TiZed/ZFTuner/ZFTuner_3D.jpg

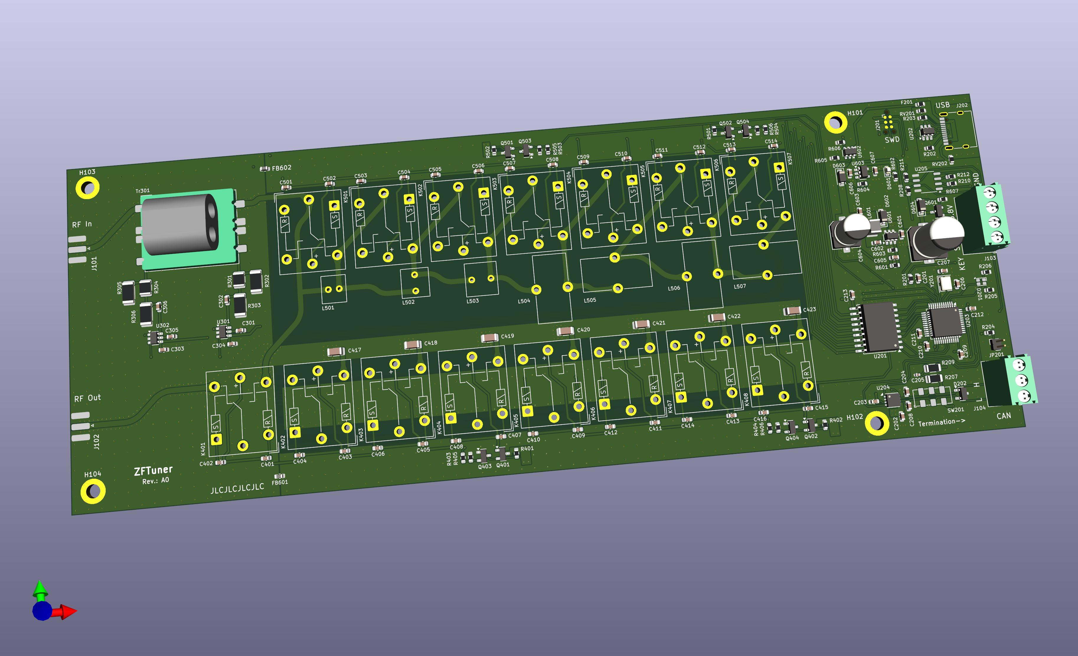
ZFTuner_3D.jpg
