TiZed/ZFTuner/ZFTuner_PCB_Editor.jpg

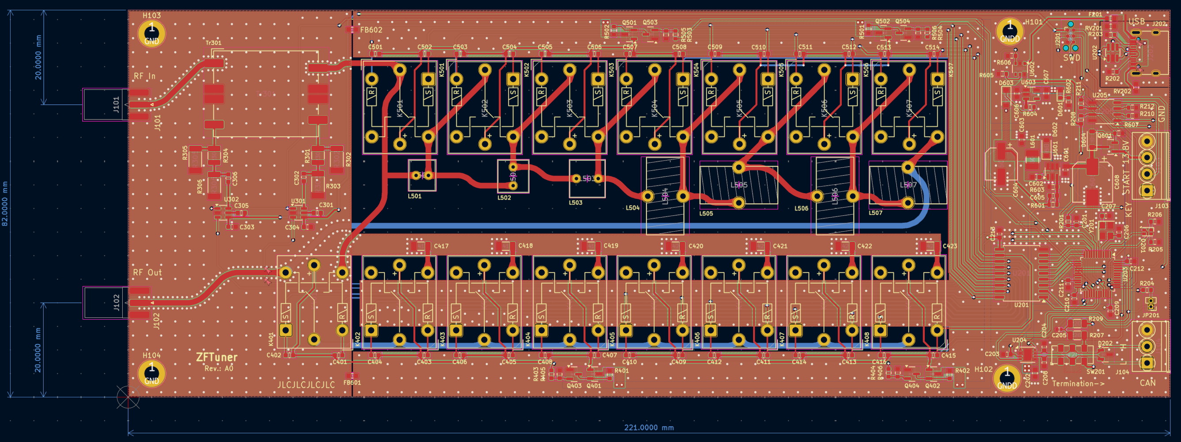
ZFTuner_PCB_Editor.jpg
