TiZed/ZFTuner/README.md

# ZFTuner

A 100W automatic antenna tuner, utilizing latching relays.

This project is still work in progress...

CC BY-NC-SA 4.0 Deed\
https://creativecommons.org/licenses/by-nc-sa/4.0/
