TiZed/ZFTuner/Coils/Coil_Form.FCStd

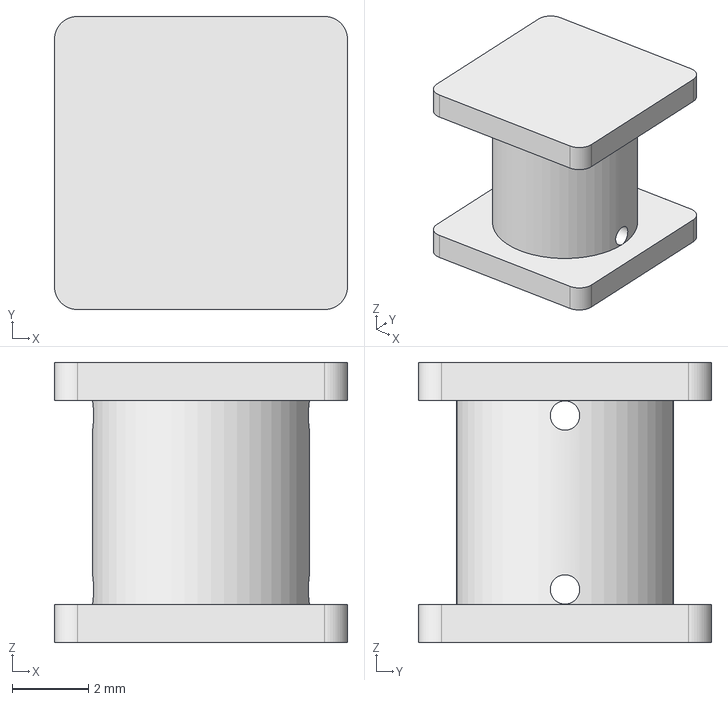
[picture p3: CAD file, 2024-04-15]
Coils/Coil_Form.FCStd
7.70 x 7.70 x 7.36 mm
