TiZed/ZFTuner/Directional_Coupler/Directional_Coupler.step

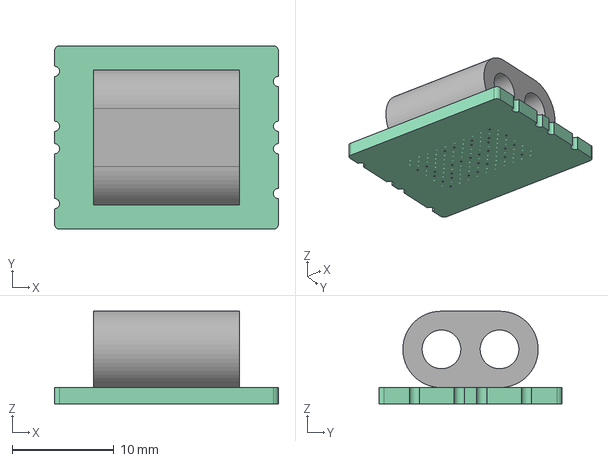
[picture p4: CAD file, 2024-03-23]
Directional_Coupler/Directional_Coupler.step
22.0 x 18.0 x 9.10 mm
Pcb_3e21
${REFERENCE}_Extrude_null
