TiZed/ZFTuner/Coils/Coil_Form-4.3D_3.35CL_5.35L_6.3H_50.5nH_N3.stl

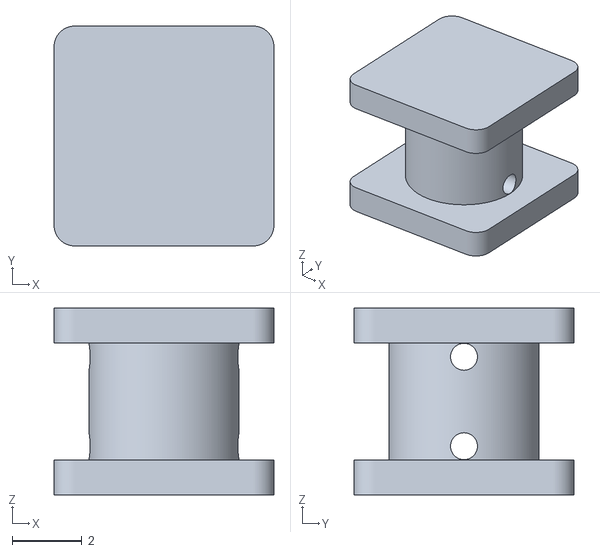
[picture p5: CAD file, 2024-04-14]
Coils/Coil_Form-4.3D_3.35CL_5.35L_6.3H_50.5nH_N3.stl
6.30 x 6.30 x 5.35
