TiZed/ZFTuner/Directional_Coupler/BN43-202.step

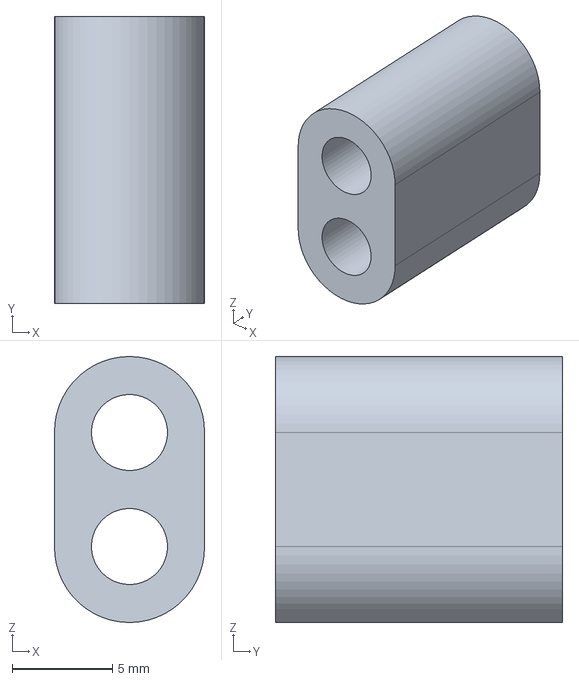
[picture p6: CAD file, 2024-03-23]
Directional_Coupler/BN43-202.step
7.50 x 14.4 x 13.3 mm
