TiZed/ZFTuner/Coils/Coil_Form-4.3D_4.69CL_6.69L_6.3H_100.3nH_N5.stl

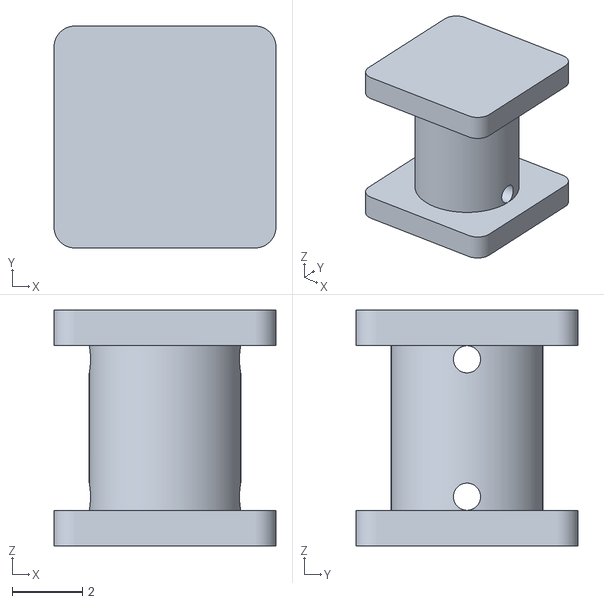
[picture p7: CAD file, 2024-04-14]
Coils/Coil_Form-4.3D_4.69CL_6.69L_6.3H_100.3nH_N5.stl
6.30 x 6.30 x 6.69
