TiZed/ZFTuner/(list of files, cad)

Other CAD files:
Coils/Coil_Form-5.7D_5.36CL_7.36L_7.7H_222nH_N6.stl
Directional_Coupler/Directional_Coupler.FCStd
