TiZed/ZFTuner/Firmware/LTC55507_Characteristics.ods

RF Power | Vout
[dBm] | [mV]
-34 | 270
-30 | 275
-26 | 280
-22 | 310
-18 | 350
-16 | 400
-14 | 460
-12.5 | 500
-10 | 580
-6 | 675
-5 | 700
-2 | 775
0 | 850
1 | 900
2 | 950
4 | 1080
6 | 1250
8 | 1450
10 | 1700
12 | 2000
14 | 2400
