TiZed/ZFTuner/ZFTuner.pdf

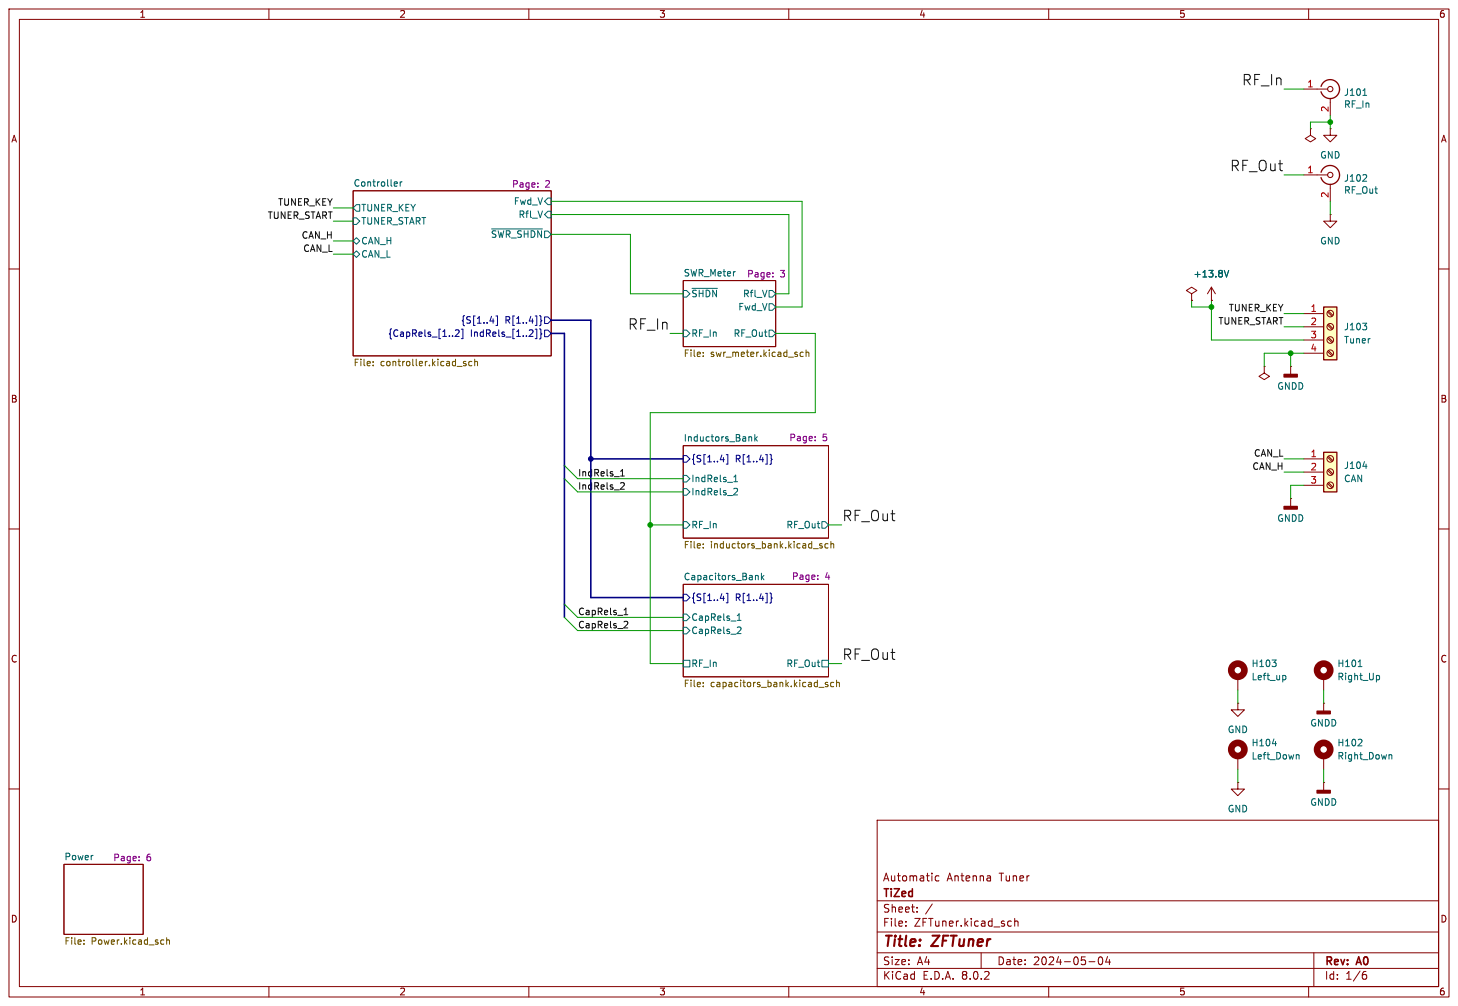
[picture p8: page 1]

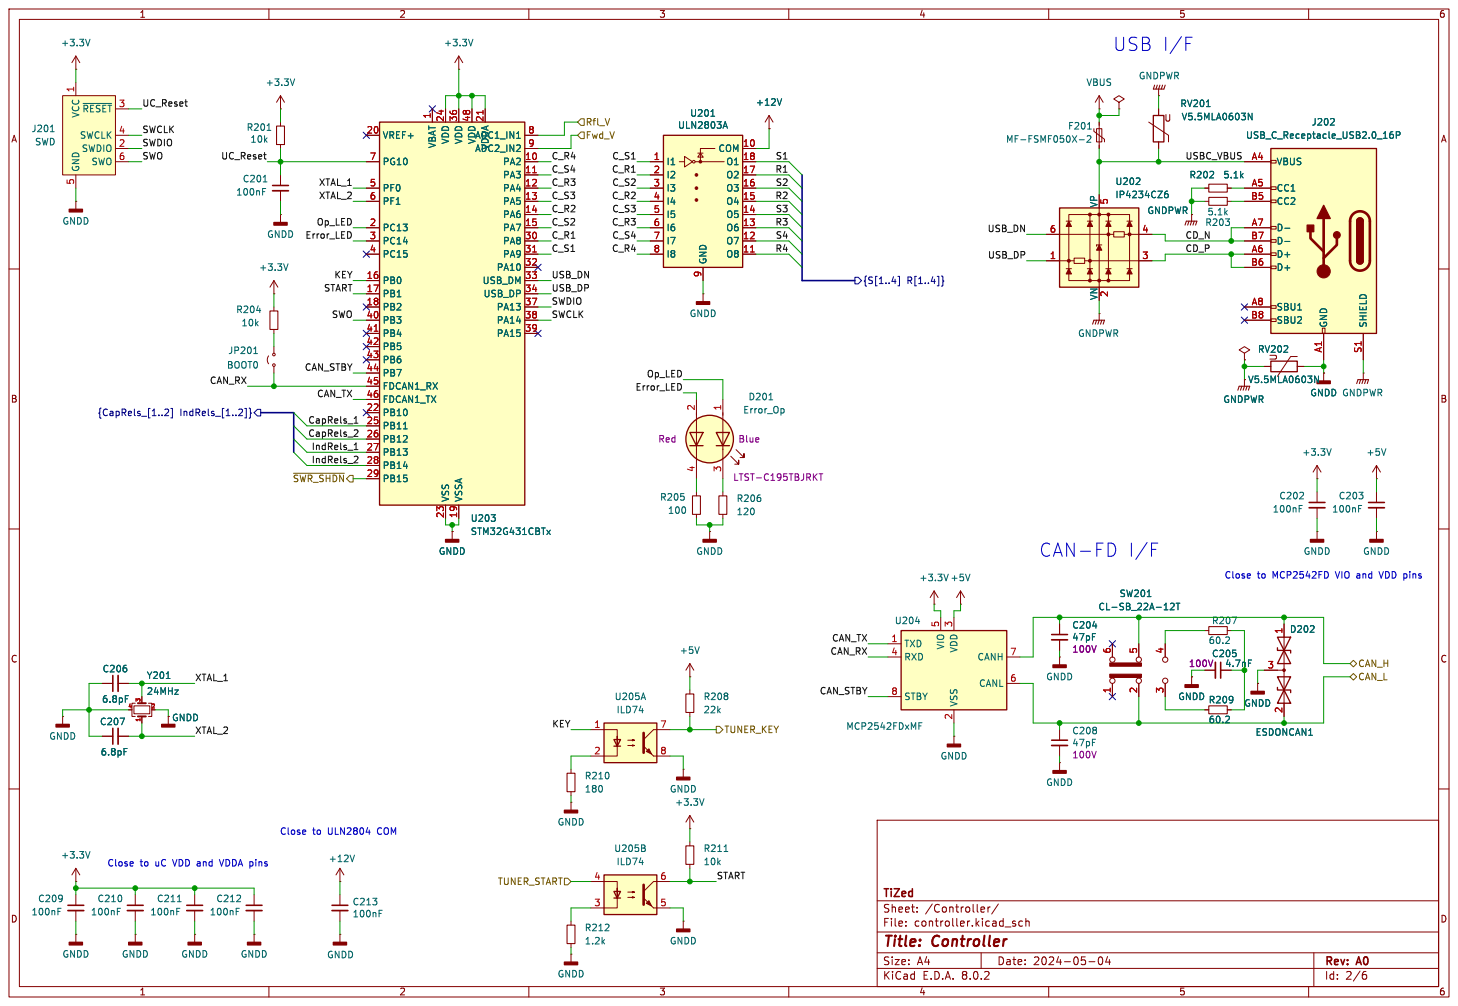
[picture p9: page 2]

1 PA2 10 PA3 11 PA4 12 PA5 13 PA6 14 PA7 15 PB0 16 PB1 17 PB2 18 VSSA 19 PC13 2 VREF+ 20 VDDA 21 PB10 22 VSS 23 VDD 24 PB11 25 PB12 26 PB13 27 PB14 28 PB15 29 PC14 3 PA8 30 PA9 31 PA10 32 USB_DM 33 USB_DP 34 VDD 36 PA13 37 PA14 38 PA15 39 PC15 4 PB3 40 PB4 41 PB5 42 PB6 43 PB7 44 FDCAN1_RX 45 FDCAN1_TX 46 VDD 48 PF0 5 PF1 6 PG10 7 ADC1_IN1 8 ADC2_IN2 9 U203 STM32G431CBTx GNDD

1 PA2 10 PA3 11 PA4 12 PA5 13 PA6 14 PA7 15 PB0 16 PB1 17 PB2 18 VSSA 19 PC13 2 VREF+ 20 VDDA 21 PB10 22 VSS 23 VDD 24 PB11 25 PB12 26 PB13 27 PB14 28 PB15 29 PC14 3 PA8 30 PA9 31 PA10 32 USB_DM 33 USB_DP 34 VDD 36 PA13 37 PA14 38 PA15 39 PC15 4 PB3 40 PB4 41 PB5 42 PB6 43 PB7 44 FDCAN1_RX 45 FDCAN1_TX 46 VDD 48 PF0 5 PF1 6 PG10 7 ADC1_IN1 8 ADC2_IN2 9 C207

Close to MCP2542FD VIO and VDD pins

Close to uC VDD and VDDA pins Close to ULN2804 COM

Id: 2/6 Title: Controller File: controller.kicad_sch Sheet: /Controller/ TiZed R212

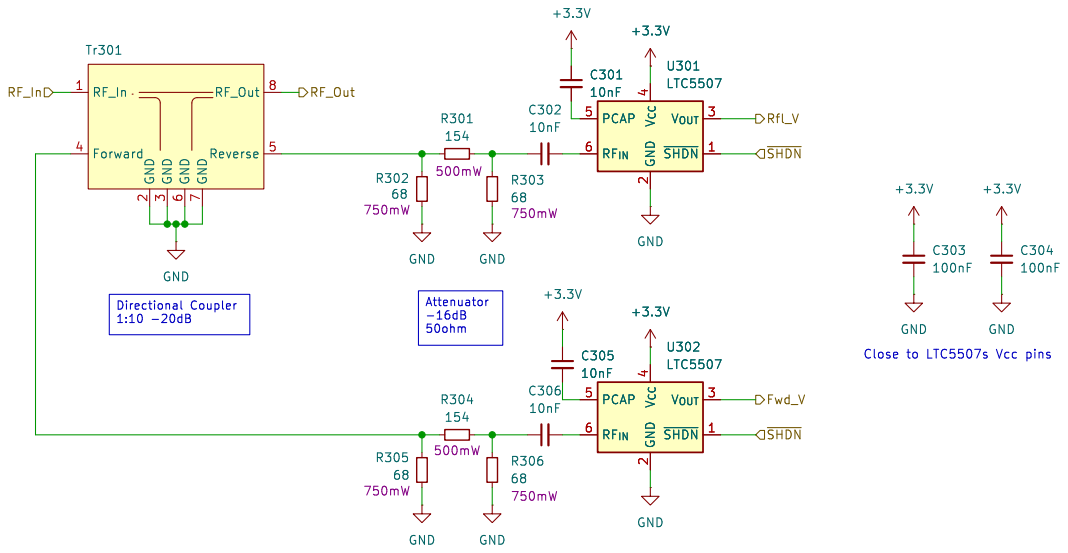
[picture p10: page 3]

2 V_{OUT} 3 V_{CC} 4 PCAP 5 RF_{IN} 6 +3.3V C301

2 V_{OUT} 3 V_{CC} 4 PCAP 5 RF_{IN} 6 U301

2 V_{OUT} 3 V_{CC} 4 PCAP 5 RF_{IN} 6 +3.3V U302

2 V_{OUT} 3 V_{CC} 4 PCAP 5 RF_{IN} 6 U302

Id: 3/6 Title: SWR Meter File: swr_meter.kicad_sch Sheet: /SWR_Meter/ TiZed

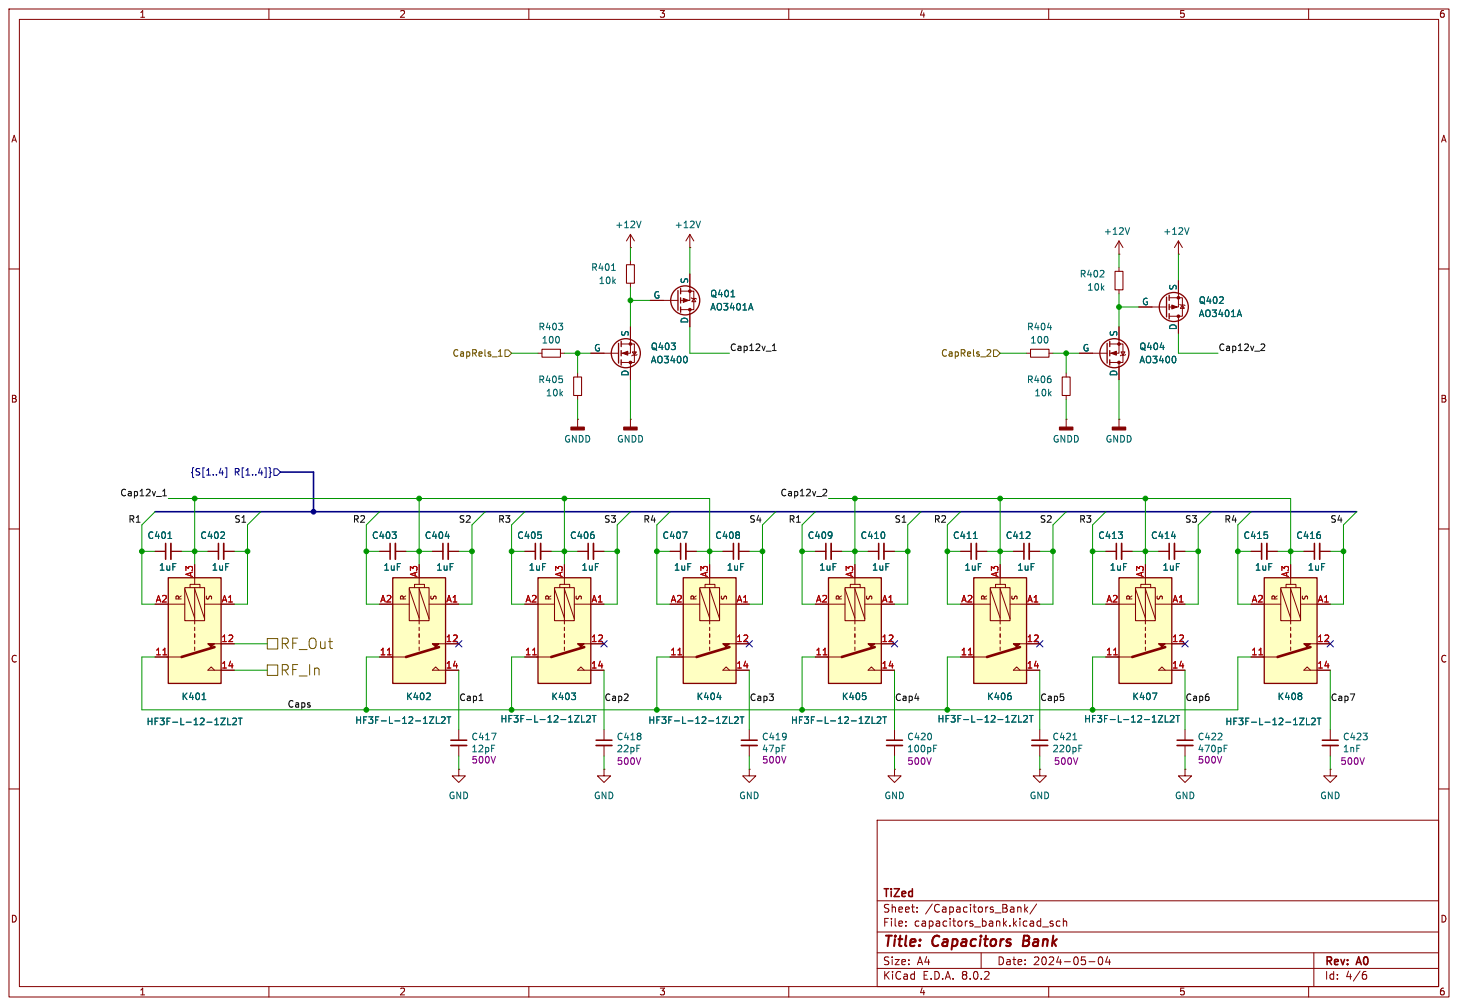
[picture p11: page 4]

Id: 4/6 Title: Capacitors Bank

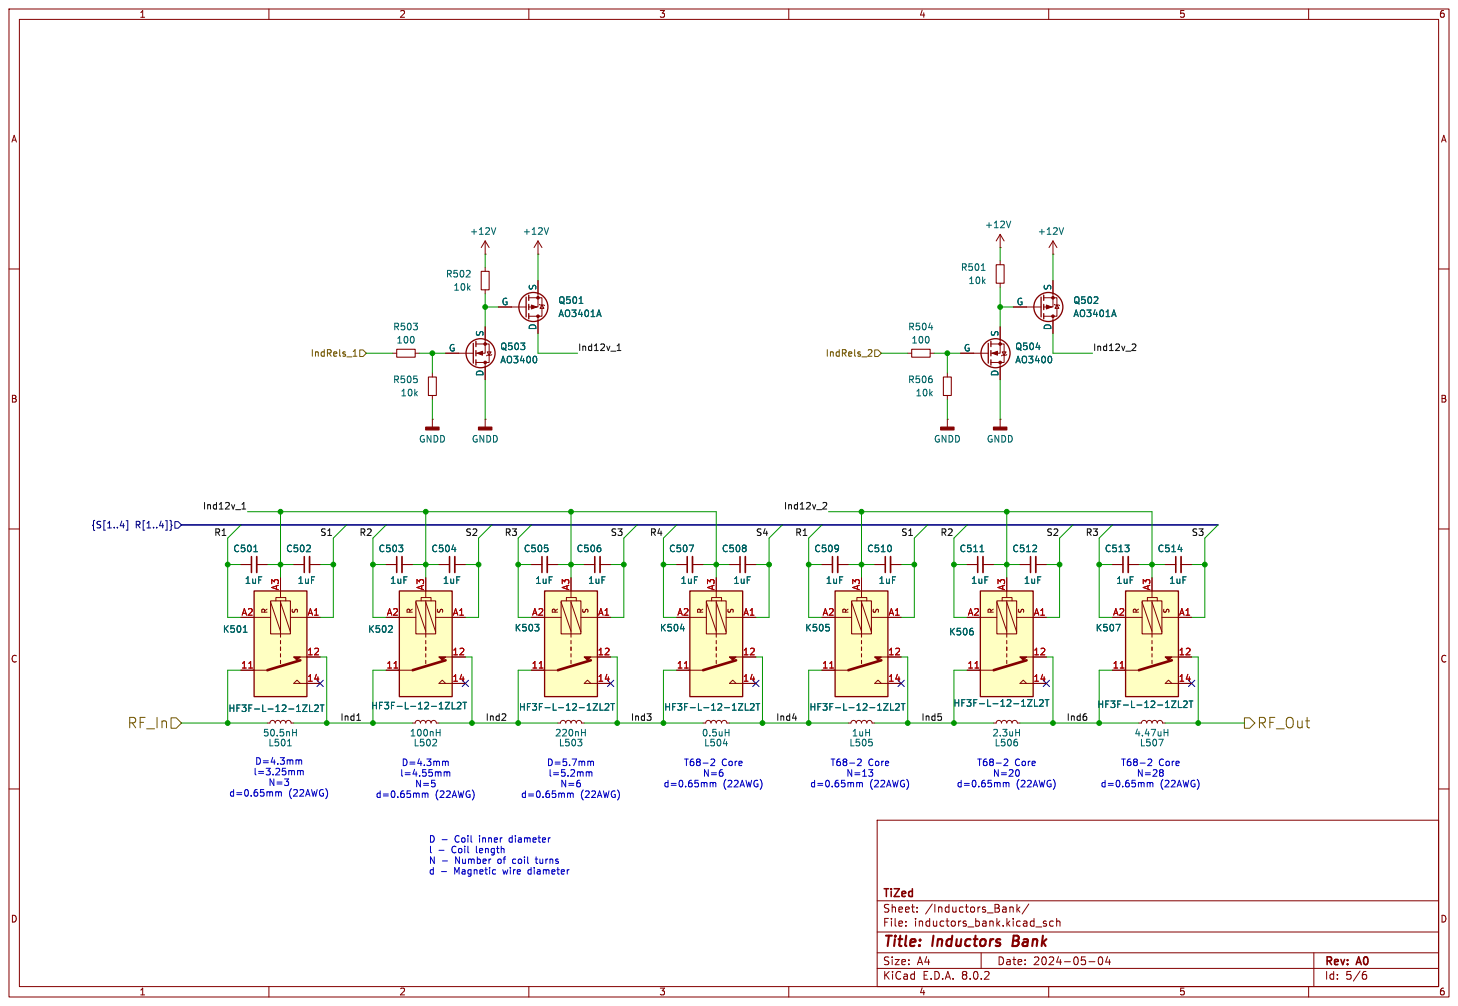
[picture p12: page 5]

Id: 5/6 Title: Inductors Bank

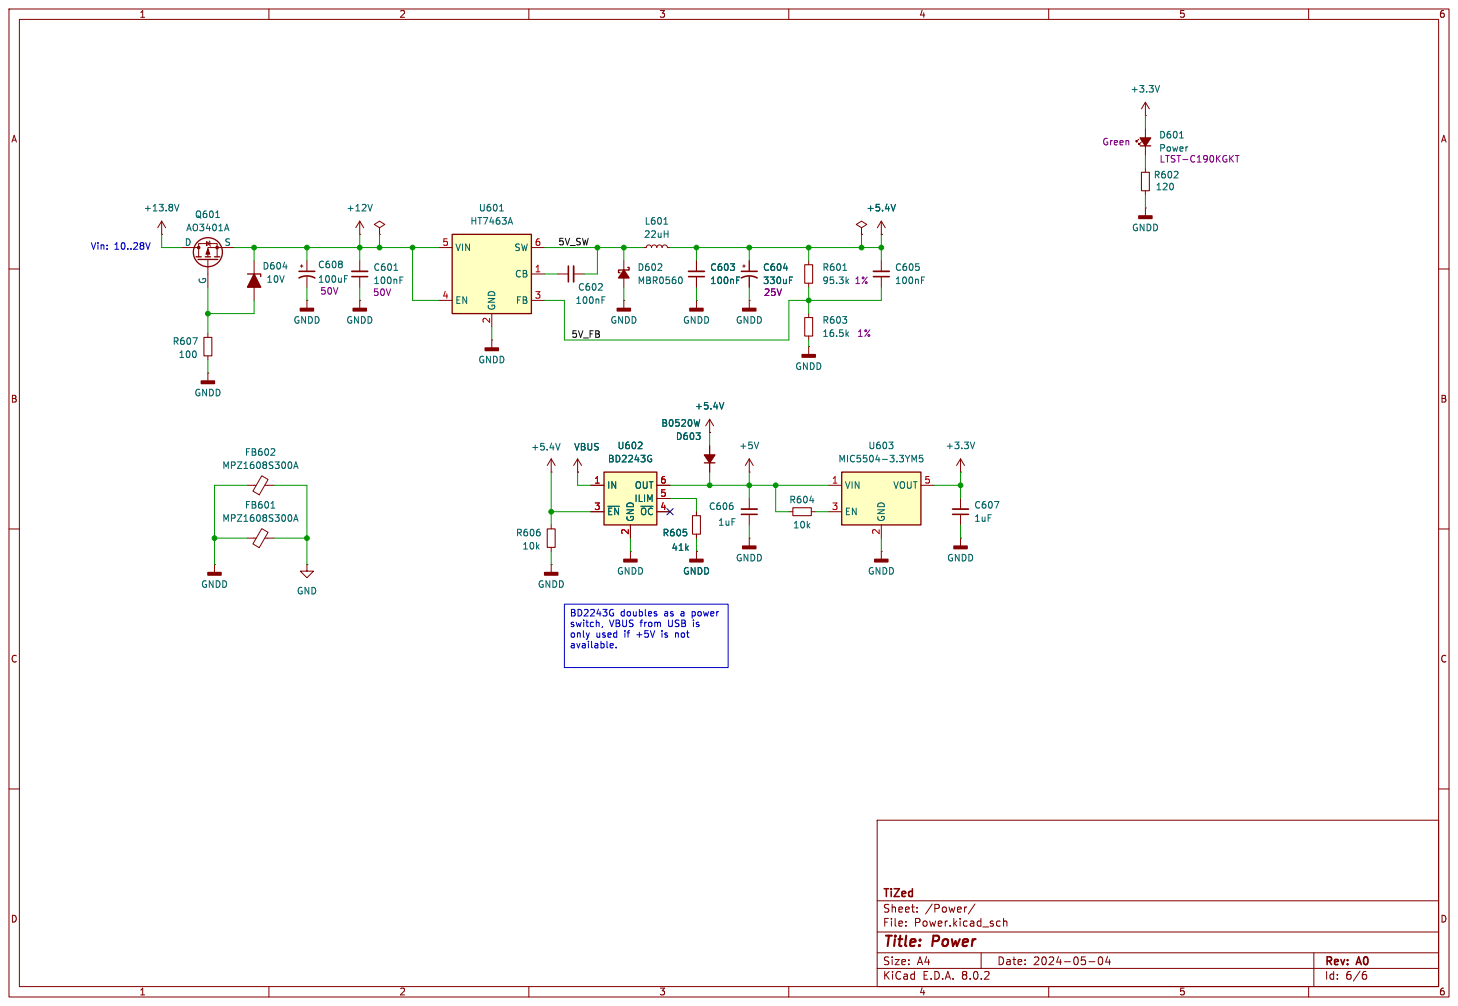
[picture p13: page 6]

2 FB 3 EN 4 VIN 5 SW 6 U601 HT7463A GNDD GNDD

Id: 6/6 Title: Power File: Power.kicad_sch Sheet: /Power/ TiZed
