TiZed/ZFTuner/Directional_Coupler/Directional_Coupler.pdf

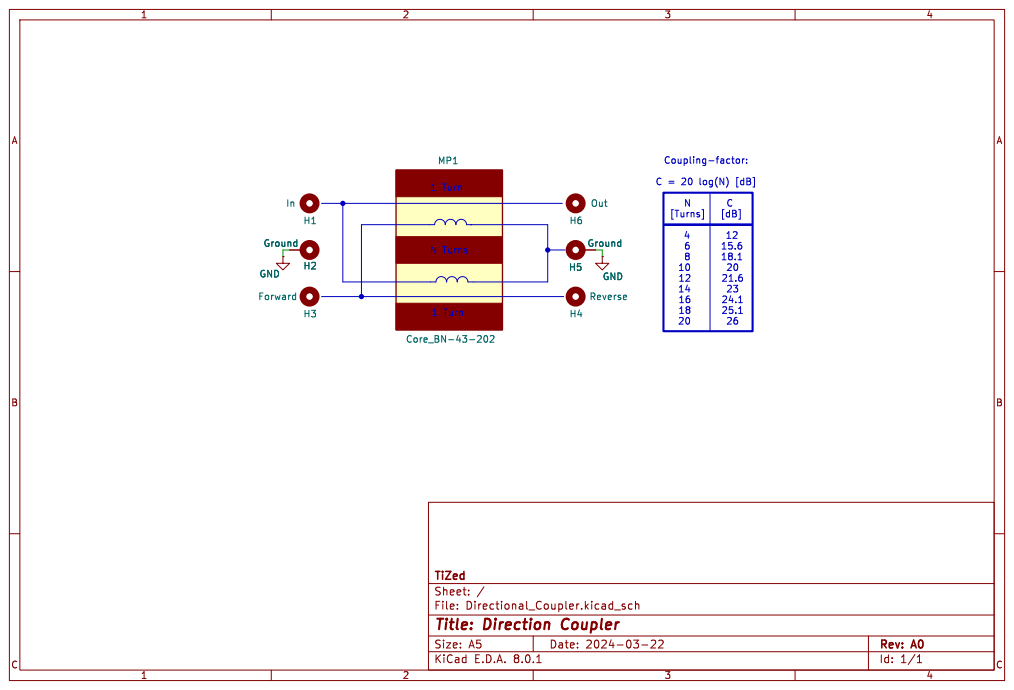
[picture p14: page 1]

[Turns] | [dB] 4 12
