TiZed/ZFTuner/Directional_Coupler/Directional_Coupler_Dim.pdf

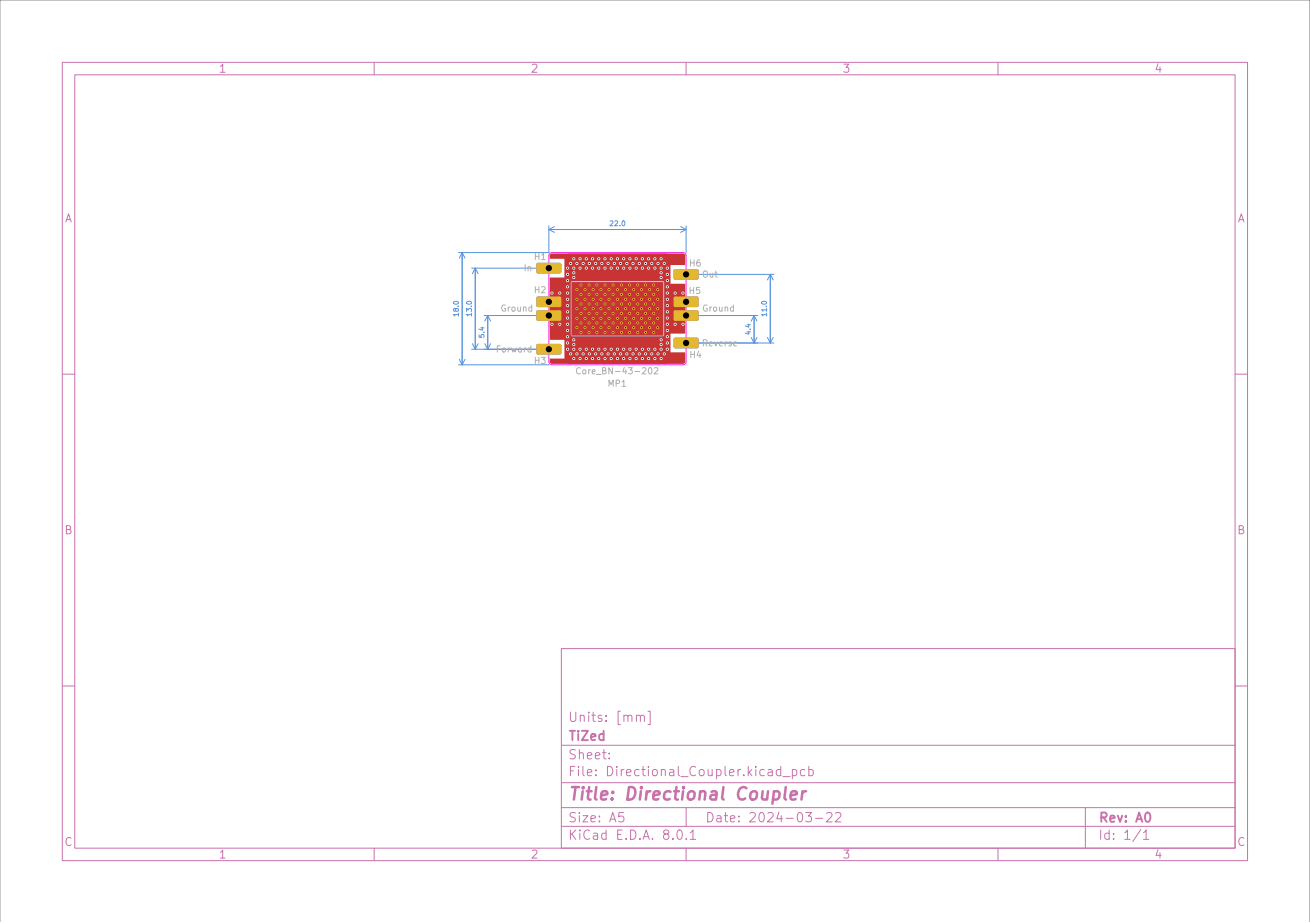
[picture p15: page 1]
