TiZed/ZFTuner/ZFTuner.kicad_pcb

## KiCad design ZFTuner.kicad_pcb (2025-08-20)

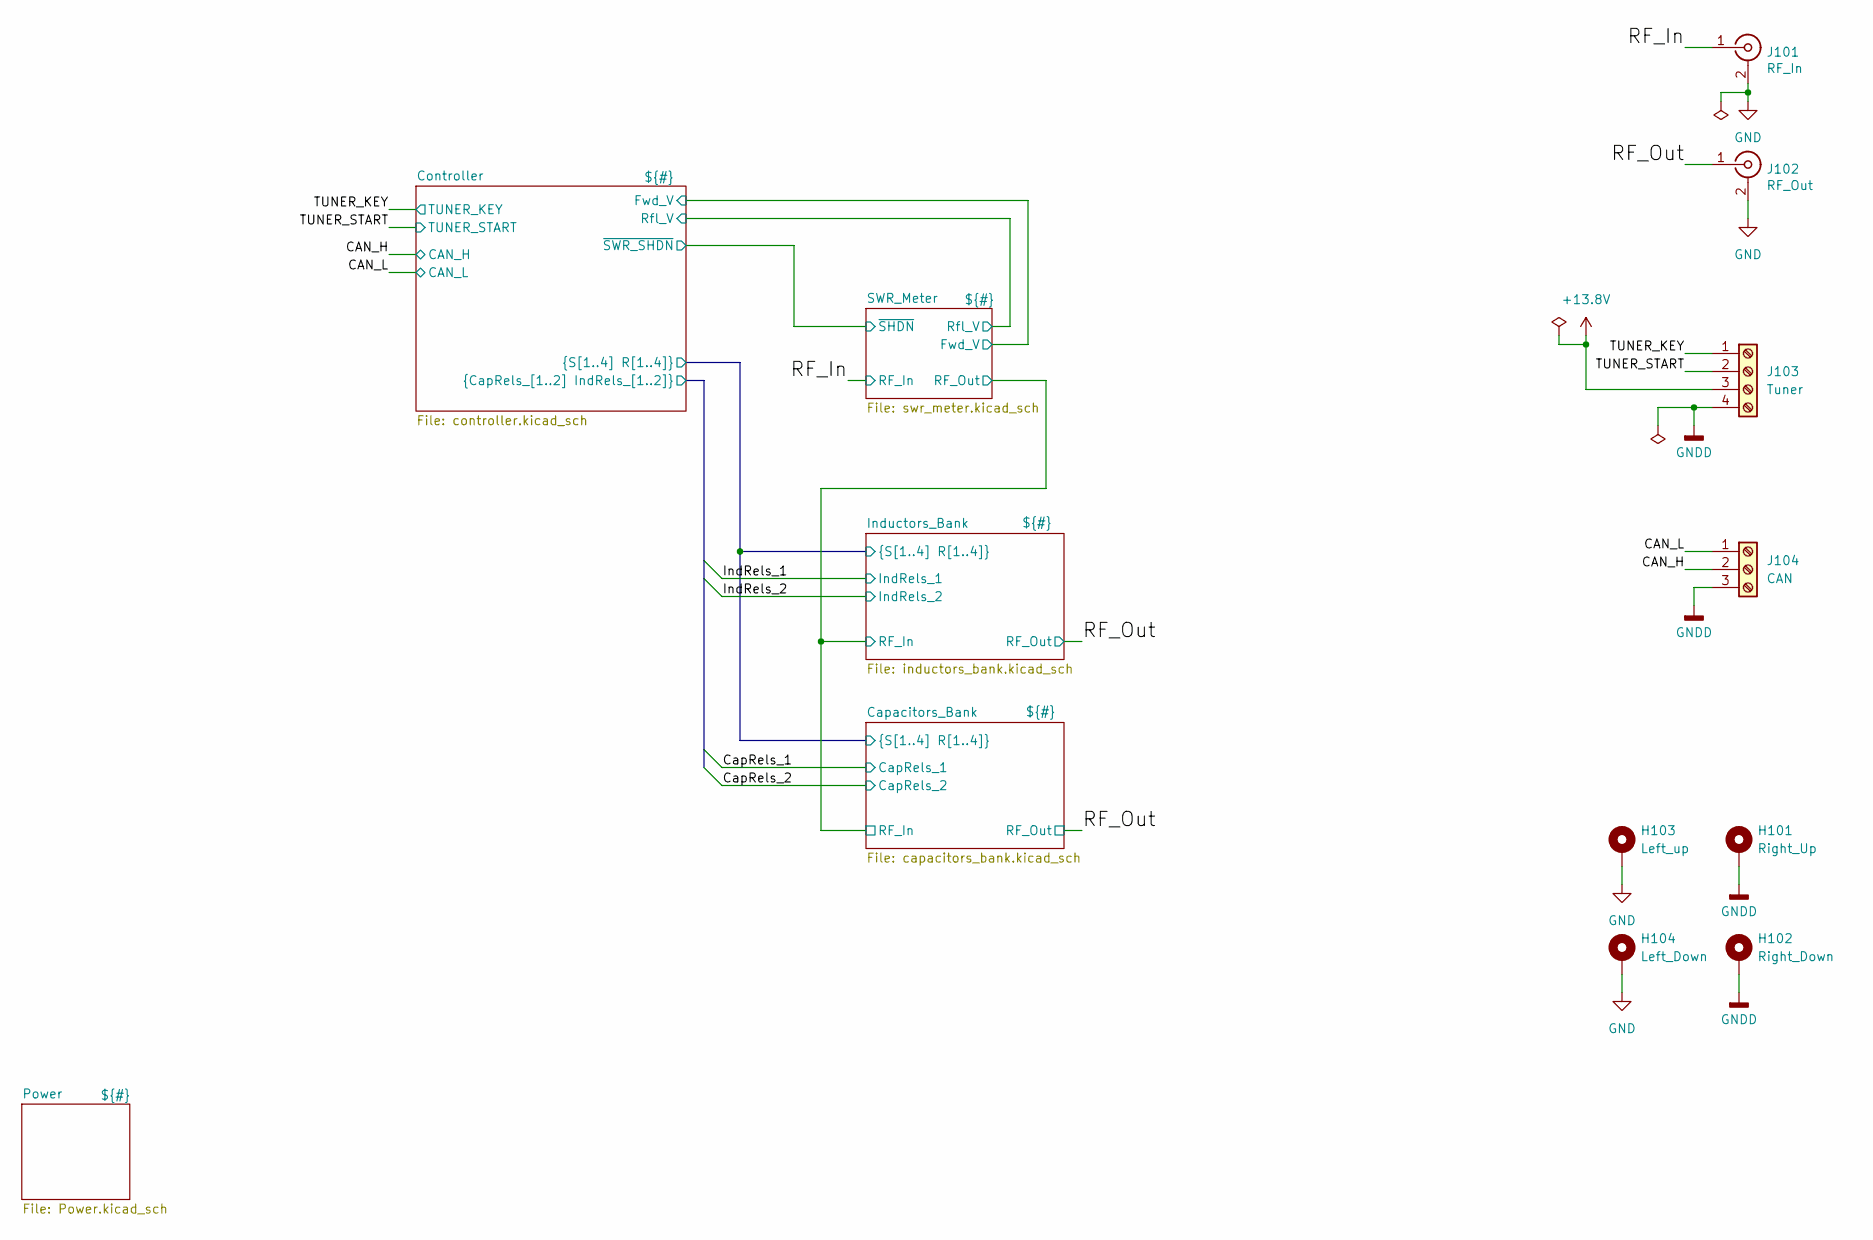
[picture p16: schematic ZFTuner.kicad_sch]

Parts:
H101: Right_Up; MountingHole_3.2mm_M3_ISO7380_Pad
H102: Right_Down; MountingHole_3.2mm_M3_ISO7380_Pad
H103: Left_up; MountingHole_3.2mm_M3_ISO7380_Pad
H104: Left_Down; MountingHole_3.2mm_M3_ISO7380_Pad
J101: RF_In; SMA_Bat_Wireless_BWSMA-KE-P001_EdgeMount_1.6mm-PCB
J102: RF_Out; SMA_Bat_Wireless_BWSMA-KE-P001_EdgeMount_1.6mm-PCB
J103: Tuner; TerminalBlock_Phoenix_PT-1,5-4-3.5-H_1x04_P3.50mm_Horizontal
J104: CAN; TerminalBlock_Phoenix_PT-1,5-3-3.5-H_1x03_P3.50mm_Horizontal

Connections:
+13.8V: J103.3; also elsewhere on the board
/CAN_H: J104.2; also elsewhere on the board
/CAN_L: J104.1; also elsewhere on the board
/RF_In: J101.1 (In); also elsewhere on the board
/RF_Out: J102.1 (In); also elsewhere on the board
/TUNER_KEY: J103.1; also elsewhere on the board
/TUNER_START: J103.2; also elsewhere on the board
GND: H103.1, H104.1, J101.2 (Ext), J102.2 (Ext); also elsewhere on the board
GNDD: H101.1, H102.1, J103.4, J104.3; also elsewhere on the board

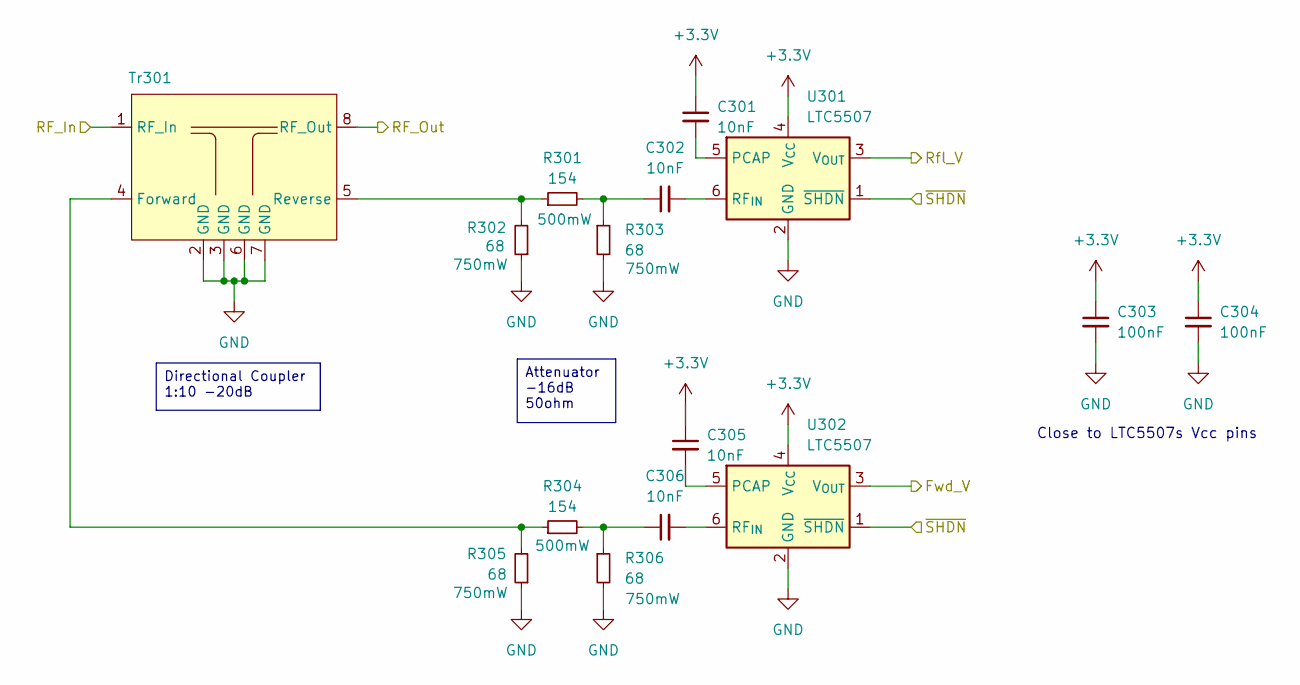
[picture p17: schematic swr_meter.kicad_sch, SWR Meter]

Parts:
C301, C302, C305, C306: 10nF; C_0603_1608Metric
C303, C304: 100nF; C_0603_1608Metric
R301, R304: 154; R_1210_3225Metric
R302, R303, R305, R306: 68; R_2010_5025Metric
Tr301: Direction_Coupler
U301, U302: LTC5507; TSOT-23-6

Connections:
+3.3V: C301.1, C303.1, C304.1, C305.1, U301.4 (V_{CC}), U302.4 (V_{CC}); also elsewhere on the board
/Capacitors_Bank/RF_In: Tr301.8 (RF_Out); also elsewhere on the board
/Controller/Fwd_V: U302.3 (V_{OUT}); also elsewhere on the board
/Controller/Rfl_V: U301.3 (V_{OUT}); also elsewhere on the board
/Controller/~SWR_SHDN: U301.1 (~SHDN), U302.1 (~SHDN); also elsewhere on the board
/RF_In: Tr301.1 (RF_In); also elsewhere on the board
GND: C303.2, C304.2, R302.1, R303.2, R305.1, R306.2, Tr301.2 (GND), Tr301.3 (GND), Tr301.6 (GND), Tr301.7 (GND), U301.2 (GND), U302.2 (GND); also elsewhere on the board
unnamed: C302.1, R301.2, R303.1
unnamed: C306.1, R304.2, R306.1
unnamed: R304.1, R305.2, Tr301.4 (Forward)
unnamed: R301.1, R302.2, Tr301.5 (Reverse)
unnamed: C301.2, U301.5 (PCAP)
unnamed: C302.2, U301.6 (RF_{IN})
unnamed: C305.2, U302.5 (PCAP)
unnamed: C306.2, U302.6 (RF_{IN})

Notes on the sheet:
Close to LTC5507s Vcc pins
Attenuator -16dB 50ohm
Directional Coupler 1:10 -20dB

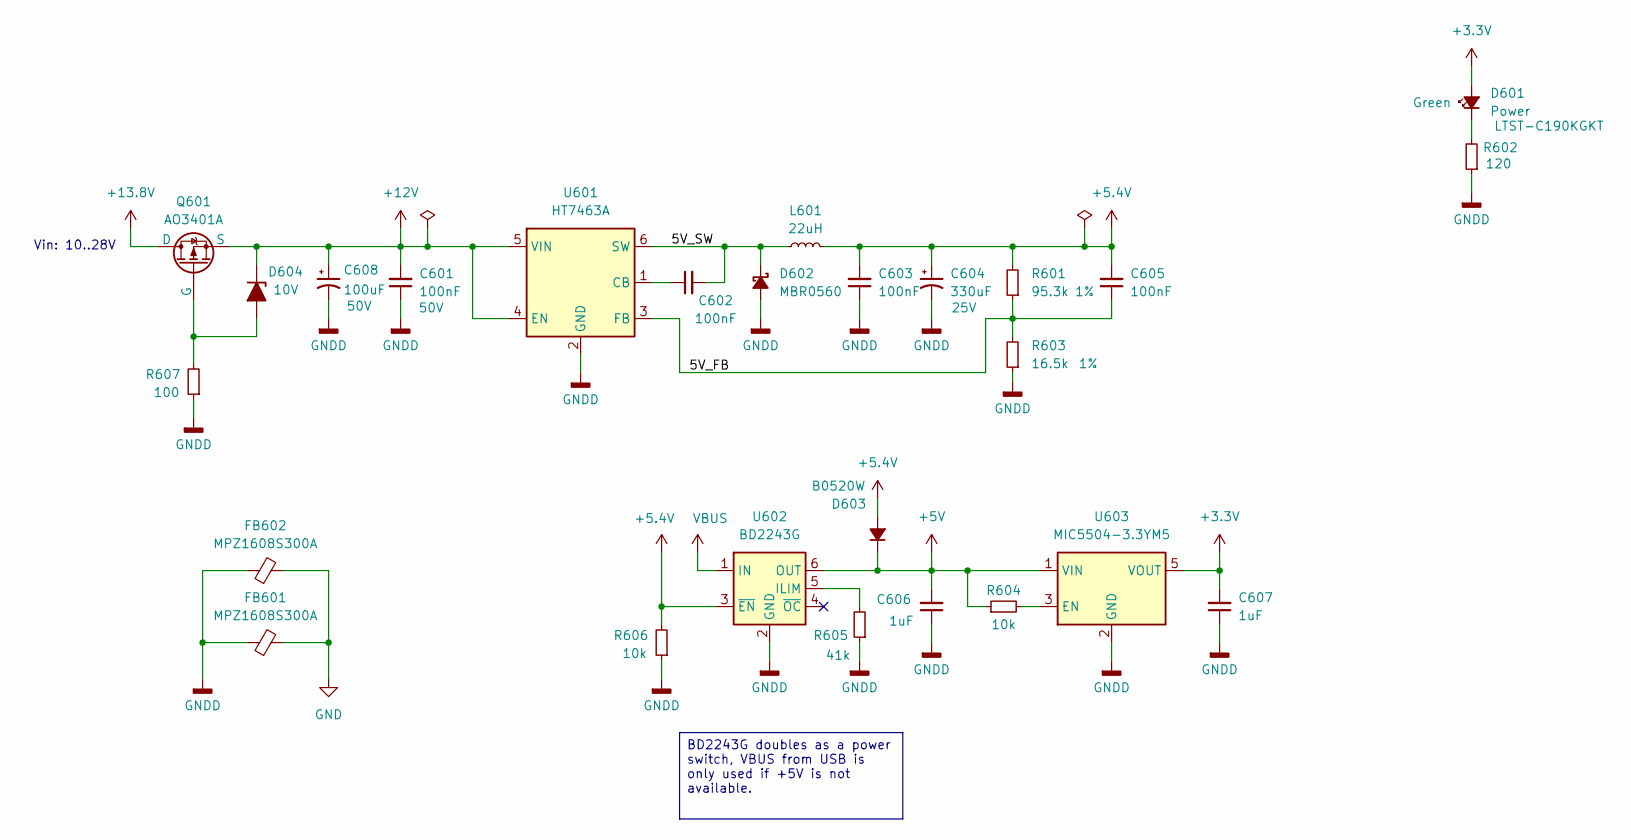
[picture p18: schematic Power.kicad_sch]

Parts:
C601: 100nF; C_0603_1608Metric; Voltage 50V
C602, C603, C605: 100nF; C_0603_1608Metric
C604: 330uF; CP_Elec_6.3x7.7; Voltage 25V; Partnumber 189RV0016
C606, C607: 1uF; C_0603_1608Metric
C608: 100uF; CP_Elec_8x10; Voltage 50V; Partnumber UUD1H101MNL1GS
D601: Power; LED_0603_1608Metric; Part LTST-C190KGKT
D602: MBR0560; D_SOD-123; Partnumber MBR0560
D603: B0520W; D_SOD-123
D604: 10V; D_SOD-123; Partnumber BZT52C10
FB601, FB602: MPZ1608S300A; L_0603_1608Metric
L601: 22uH; L_1210_3225Metric; Partnumber NLCV32T-220K-PF
Q601: AO3401A; SOT-23
R601: 95.3k; R_0603_1608Metric; Tolerance 1%
R602: 120; R_0603_1608Metric
R603: 16.5k; R_0603_1608Metric; Tolerance 1%
R604, R606: 10k; R_0603_1608Metric
R605: 41k; R_0603_1608Metric
R607: 100; R_0603_1608Metric
U601: HT7463A; SOT-23-6; Partnumber HT7463A
U602: BD2243G; TSOP-6_1.65x3.05mm_P0.95mm
U603: MIC5504-3.3YM5; SOT-23-5

Connections:
+3.3V: C607.2, D601.2 (A), U603.5 (VOUT); also elsewhere on the board
+5.4V: C603.2, C604.1, C605.2, D603.2 (A), L601.2, R601.2, R606.2, U602.3 (~EN)
+5V: C606.2, D603.1 (K), R604.1, U602.6 (OUT), U603.1 (VIN); also elsewhere on the board
+12V: C601.2, C608.1, D604.1 (K), Q601.3 (S), U601.4 (EN), U601.5 (VIN); also elsewhere on the board
+13.8V: Q601.1 (D); also elsewhere on the board
/Power/5V_FB: C605.1, R601.1, R603.2, U601.3 (FB)
/Power/5V_SW: C602.2, D602.1 (K), L601.1, U601.6 (SW)
GND: FB601.2, FB602.2; also elsewhere on the board
GNDD: C601.1, C603.1, C604.2, C606.1, C607.1, C608.2, D602.2 (A), FB601.1, FB602.1, R602.1, R603.1, R605.1, R606.1, R607.1, U601.2 (GND), U602.2 (GND), U603.2 (GND); also elsewhere on the board
unnamed: D601.1 (K), R602.2
unnamed: D604.2 (A), Q601.2 (G), R607.2
unnamed: C602.1, U601.1 (CB)
unnamed: R605.2, U602.5 (ILIM)
unnamed: R604.2, U603.3 (EN)
VBUS: U602.1 (IN); also elsewhere on the board

Notes on the sheet:
Vin: 10..28V
BD2243G doubles as a power switch, VBUS from USB is only used if +5V is not available.

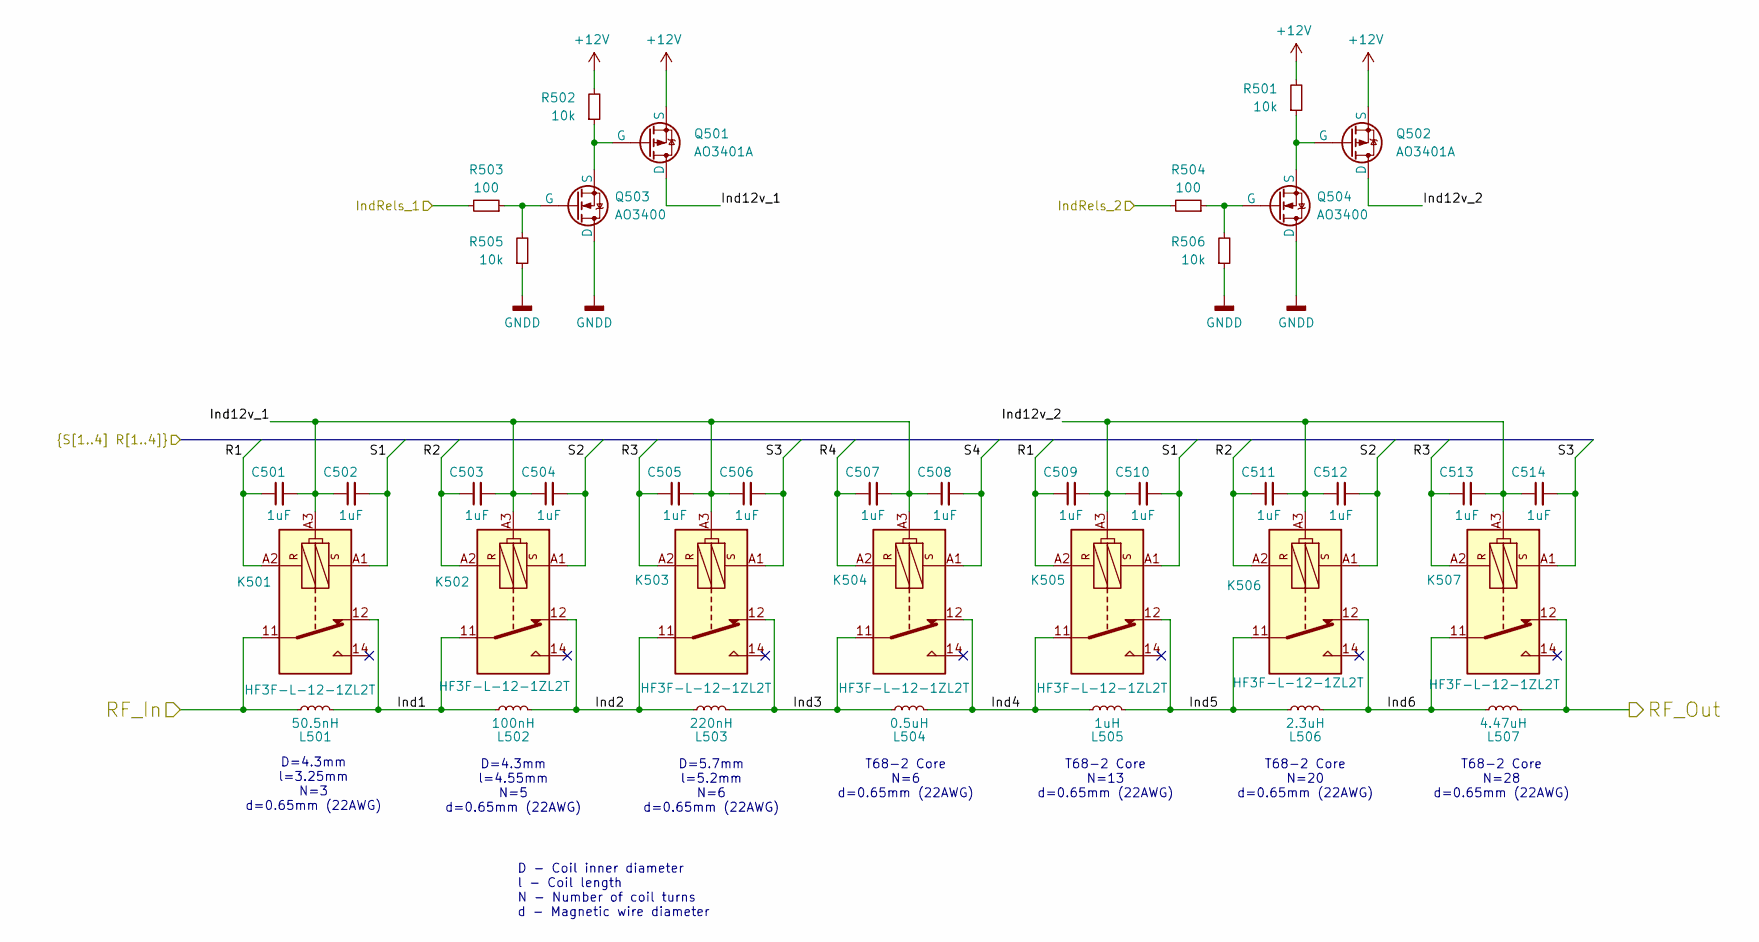
[picture p19: schematic inductors_bank.kicad_sch, Inductors Bank]

Parts:
C501, C502, C503, C504, C505, C506, C507, C508, C509, C510, C511, C512, C513, C514: 1uF; C_0603_1608Metric
K501, K502, K503, K504, K505, K506, K507: HF3F-L-12-1ZL2T; Relay_SPDT_Hongfa_HF3F-L-xx-1ZL2T
L501: 50.5nH; Inductor_3DP_N3_L5.35mm_W6.3mm_P2.58mm
L502: 100nH; Inductor_3DP_N5_L6.69mm_W6.3mm_P3.92mm
L503: 220nH; Inductor_3DP_N6_L7.36mm_W7.7mm_P4.59mm
L504: 0.5uH; Toroid_Vertical_L19.5mm_W8.0mm_P7.5mm
L505: 1uH; Toroid_Vertical_L19.5mm_W8.0mm_P7.5mm
L506: 2.3uH; Toroid_Vertical_L19.5mm_W8.0mm_P7.5mm
L507: 4.47uH; Toroid_Vertical_L19.5mm_W8.0mm_P7.5mm
Q501, Q502: AO3401A; SOT-23
Q503, Q504: AO3400; SOT-23
R501, R502, R505, R506: 10k; R_0603_1608Metric
R503, R504: 100; R_0603_1608Metric

Connections:
+12V: Q501.3 (S), Q502.3 (S), R501.2, R502.2; also elsewhere on the board
/Capacitors_Bank/R1: C501.1, C509.1, K501.A2, K505.A2; also elsewhere on the board
/Capacitors_Bank/R2: C503.1, C511.1, K502.A2, K506.A2; also elsewhere on the board
/Capacitors_Bank/R3: C505.1, C513.1, K503.A2, K507.A2; also elsewhere on the board
/Capacitors_Bank/R4: C507.1, K504.A2; also elsewhere on the board
/Capacitors_Bank/RF_In: K501.11, L501.1; also elsewhere on the board
/Capacitors_Bank/S1: C502.2, C510.2, K501.A1, K505.A1; also elsewhere on the board
/Capacitors_Bank/S2: C504.2, C512.2, K502.A1, K506.A1; also elsewhere on the board
/Capacitors_Bank/S3: C506.2, C514.2, K503.A1, K507.A1; also elsewhere on the board
/Capacitors_Bank/S4: C508.2, K504.A1; also elsewhere on the board
/Controller/IndRels_1: R503.2; also elsewhere on the board
/Controller/IndRels_2: R504.2; also elsewhere on the board
/Inductors_Bank/Ind1: K501.12, K502.11, L501.2, L502.1
/Inductors_Bank/Ind2: K502.12, K503.11, L502.2, L503.1
/Inductors_Bank/Ind3: K503.12, K504.11, L503.2, L504.1
/Inductors_Bank/Ind4: K504.12, K505.11, L504.2, L505.1
/Inductors_Bank/Ind5: K505.12, K506.11, L505.2, L506.1
/Inductors_Bank/Ind6: K506.12, K507.11, L506.2, L507.1
/Inductors_Bank/Ind12v_1: C501.2, C502.1, C503.2, C504.1, C505.2, C506.1, C507.2, C508.1, K501.A3, K502.A3, K503.A3, K504.A3, Q501.1 (D)
/Inductors_Bank/Ind12v_2: C509.2, C510.1, C511.2, C512.1, C513.2, C514.1, K505.A3, K506.A3, K507.A3, Q502.1 (D)
/RF_Out: K507.12, L507.2; also elsewhere on the board
GNDD: Q503.1 (D), Q504.1 (D), R505.1, R506.1; also elsewhere on the board
unnamed: Q501.2 (G), Q503.3 (S), R502.1
unnamed: Q502.2 (G), Q504.3 (S), R501.1
unnamed: Q503.2 (G), R503.1, R505.2
unnamed: Q504.2 (G), R504.1, R506.2

Notes on the sheet:
D=5.7mm l=5.2mm N=6 d=0.65mm (22AWG)
D=4.3mm l=4.55mm N=5 d=0.65mm (22AWG)
D=4.3mm l=3.25mm N=3 d=0.65mm (22AWG)
T68-2 Core N=6 d=0.65mm (22AWG)
D - Coil inner diameter l - Coil length N - Number of coil turns d - Magnetic wire diameter
T68-2 Core N=28 d=0.65mm (22AWG)
T68-2 Core N=20 d=0.65mm (22AWG)
T68-2 Core N=13 d=0.65mm (22AWG)

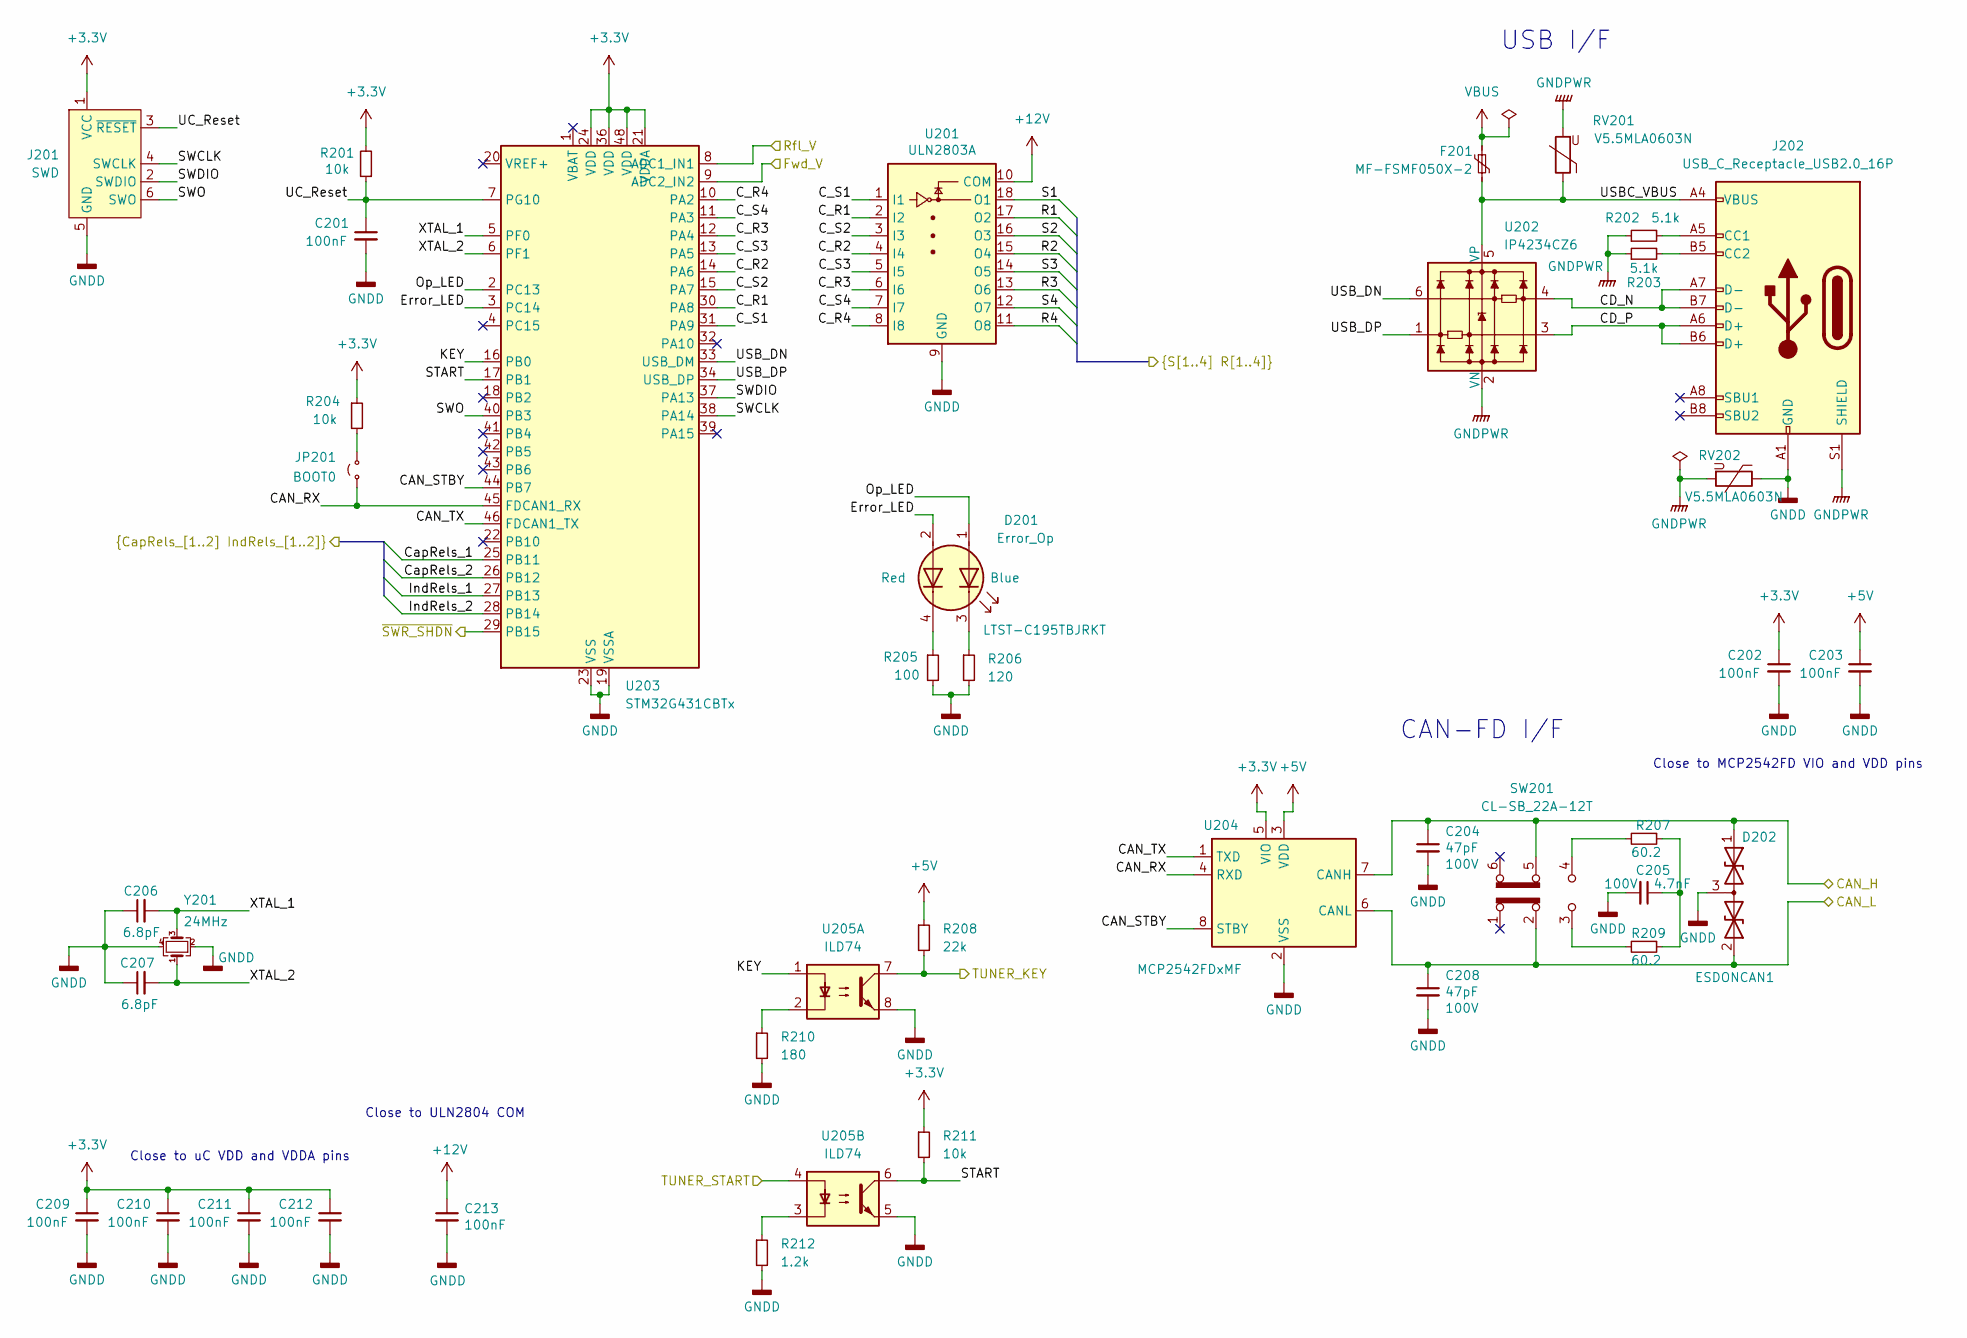
[picture p20: schematic controller.kicad_sch]

Parts:
C201, C202, C203, C209, C210, C211, C212, C213: 100nF; C_0603_1608Metric
C204, C208: 47pF; C_0603_1608Metric; Voltage 100V
C205: 4.7nF; C_0402_1005Metric; Voltage 100V
C206, C207: 6.8pF; C_0603_1608Metric
D201: Error_Op; LED_Dual_1615_1.6mm_1.5mm; Part LTST-C195TBJRKT
D202: ESDONCAN1; SOT-23
F201: MF-FSMF050X-2; Fuse_0603_1608Metric
J201: SWD; Tag-Connect_TC2030-IDC-NL_2x03_P1.27mm_Vertical
J202: USB_C_Receptacle_USB2.0_16P; USB_C_Receptacle_XKB_U262-16XN-4BVC11
JP201: BOOT0; PinHeader_1x02_P1.27mm_Vertical
R201, R204, R211: 10k; R_0603_1608Metric
R202, R203: 5.1k; R_0603_1608Metric
R205: 100; R_0603_1608Metric
R206: 120; R_0603_1608Metric
R207, R209: 60.2; R_1206_3216Metric
R208: 22k; R_0603_1608Metric
R210: 180; R_0603_1608Metric
R212: 1.2k; R_0603_1608Metric
RV201, RV202: V5.5MLA0603N; Fuse_0603_1608Metric
SW201: CL-SB_22A-12T; SW_Slide_DPDT_Nidec_CL-SB-22A
U201: ULN2803A; SOIC-18W_7.5x11.6mm_P1.27mm
U202: IP4234CZ6; SC-74-6_1.55x2.9mm_P0.95mm
U203: STM32G431CBTx; LQFP-48_7x7mm_P0.5mm
U204: MCP2542FDxMF; DFN-8-1EP_3x3mm_P0.65mm_EP1.55x2.4mm
U205: ILD74; SOP-8_3.9x4.9mm_P1.27mm
Y201: 24MHz; Crystal_SMD_3225-4Pin_3.2x2.5mm

Connections:
+3.3V: C202.1, C209.1, C210.1, C211.1, C212.1, J201.1 (VCC), R201.2, R204.1, R211.1, U203.21 (VDDA), U203.24 (VDD), U203.36 (VDD), U203.48 (VDD), U204.5 (VIO); also elsewhere on the board
+5V: C203.1, R208.1, U204.3 (VDD); also elsewhere on the board
+12V: C213.1, U201.10 (COM); also elsewhere on the board
/CAN_H: C204.1, D202.1 (A1), SW201.5 (B), U204.7 (CANH); also elsewhere on the board
/CAN_L: C208.1, D202.2 (A2), SW201.2 (B), U204.6 (CANL); also elsewhere on the board
/Capacitors_Bank/R1: U201.17 (O2); also elsewhere on the board
/Capacitors_Bank/R2: U201.15 (O4); also elsewhere on the board
/Capacitors_Bank/R3: U201.13 (O6); also elsewhere on the board
/Capacitors_Bank/R4: U201.11 (O8); also elsewhere on the board
/Capacitors_Bank/S1: U201.18 (O1); also elsewhere on the board
/Capacitors_Bank/S2: U201.16 (O3); also elsewhere on the board
/Capacitors_Bank/S3: U201.14 (O5); also elsewhere on the board
/Capacitors_Bank/S4: U201.12 (O7); also elsewhere on the board
/Controller/CAN_RX: JP201.1 (A), U203.45 (FDCAN1_RX), U204.4 (RXD)
/Controller/CAN_STBY: U203.44 (PB7), U204.8 (STBY)
/Controller/CAN_TX: U203.46 (FDCAN1_TX), U204.1 (TXD)
/Controller/CD_N: J202.A7 (D-), J202.B7 (D-), U202.4
/Controller/CD_P: J202.A6 (D+), J202.B6 (D+), U202.3
/Controller/C_R1: U201.2 (I2), U203.30 (PA8)
/Controller/C_R2: U201.4 (I4), U203.14 (PA6)
/Controller/C_R3: U201.6 (I6), U203.12 (PA4)
/Controller/C_R4: U201.8 (I8), U203.10 (PA2)
/Controller/C_S1: U201.1 (I1), U203.31 (PA9)
/Controller/C_S2: U201.3 (I3), U203.15 (PA7)
/Controller/C_S3: U201.5 (I5), U203.13 (PA5)
/Controller/C_S4: U201.7 (I7), U203.11 (PA3)
/Controller/CapRels_1: U203.25 (PB11); also elsewhere on the board
/Controller/CapRels_2: U203.26 (PB12); also elsewhere on the board
/Controller/Error_LED: D201.2 (A2), U203.3 (PC14)
/Controller/Fwd_V: U203.9 (ADC2_IN2); also elsewhere on the board
/Controller/IndRels_1: U203.27 (PB13); also elsewhere on the board
/Controller/IndRels_2: U203.28 (PB14); also elsewhere on the board
/Controller/KEY: U203.16 (PB0), U205.1
/Controller/Op_LED: D201.1 (A1), U203.2 (PC13)
/Controller/Rfl_V: U203.8 (ADC1_IN1); also elsewhere on the board
/Controller/START: R211.2, U203.17 (PB1), U205.6
/Controller/SWCLK: J201.4 (SWCLK), U203.38 (PA14)
/Controller/SWDIO: J201.2 (SWDIO), U203.37 (PA13)
/Controller/SWO: J201.6 (SWO), U203.40 (PB3)
/Controller/UC_Reset: C201.1, J201.3 (~RESET), R201.1, U203.7 (PG10)
/Controller/USBC_VBUS: F201.2, J202.A4 (VBUS), J202.A9 (VBUS), J202.B4 (VBUS), J202.B9 (VBUS), RV201.1, U202.5 (VP)
/Controller/USB_DN: U202.6, U203.33 (USB_DM)
/Controller/USB_DP: U202.1, U203.34 (USB_DP)
/Controller/XTAL_1: C206.2, U203.5 (PF0), Y201.3
/Controller/XTAL_2: C207.2, U203.6 (PF1), Y201.1
/Controller/~SWR_SHDN: U203.29 (PB15); also elsewhere on the board
/TUNER_KEY: R208.2, U205.7; also elsewhere on the board
/TUNER_START: U205.4; also elsewhere on the board
GNDD: C201.2, C202.2, C203.2, C204.2, C205.2, C206.1, C207.1, C208.2, C209.2, C210.2, C211.2, C212.2, C213.2, D202.3 (common), J201.5 (GND), J202.A1 (GND), J202.A12 (GND), J202.B1 (GND), J202.B12 (GND), R205.2, R206.2, R210.2, R212.2, RV202.1, U201.9 (GND), U203.19 (VSSA), U203.23 (VSS), U203.35 (VSS), U203.47 (VSS), U204.2 (VSS), U204.9 (VSS), U205.5, U205.8, Y201.2, Y201.4; also elsewhere on the board
GNDPWR: J202.S1 (SHIELD), R202.1, R203.1, RV201.2, RV202.2, U202.2 (VN)
unnamed: C205.1, R207.1, R209.1
unnamed: D201.3 (K1), R206.1
unnamed: D201.4 (K2), R205.1
unnamed: J202.A5 (CC1), R202.2
unnamed: J202.B5 (CC2), R203.2
unnamed: JP201.2 (B), R204.2
unnamed: R207.2, SW201.4 (A)
unnamed: R209.2, SW201.3 (C)
unnamed: R210.1, U205.2
unnamed: R212.1, U205.3
VBUS: F201.1; also elsewhere on the board

Notes on the sheet:
Close to uC VDD and VDDA pins
USB I/F
Close to MCP2542FD VIO and VDD pins
Close to ULN2804 COM
CAN-FD I/F

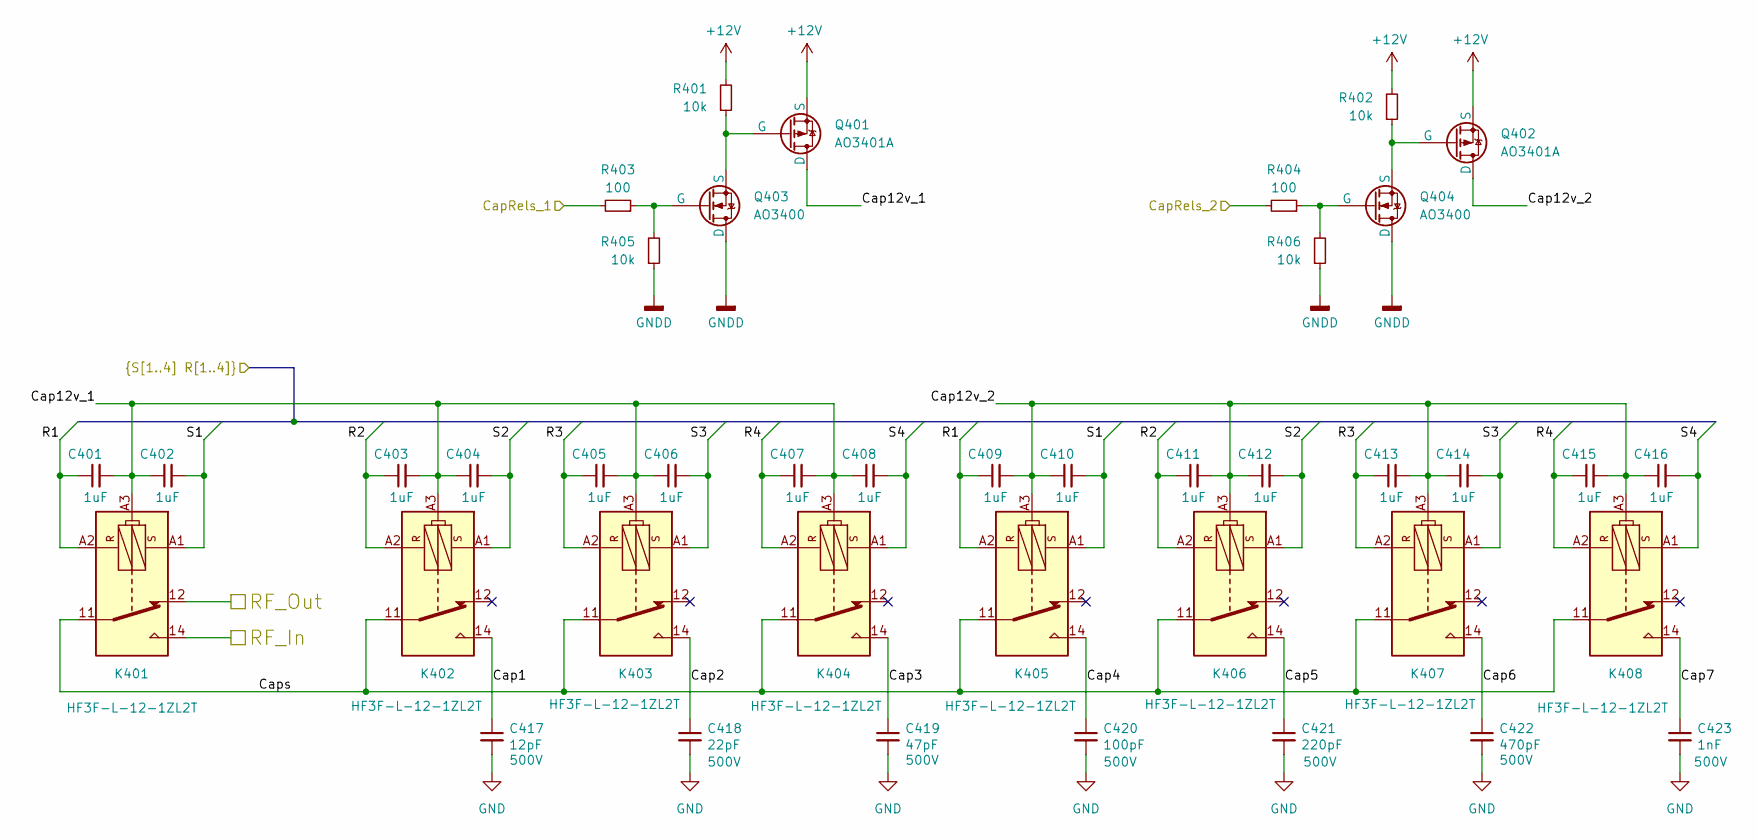
[picture p21: schematic capacitors_bank.kicad_sch, Capacitors Bank]

Parts:
C401, C402, C403, C404, C405, C406, C407, C408, C409, C410, C411, C412, C413, C414, C415, C416: 1uF; C_0603_1608Metric
C417: 12pF; C_1206_3216Metric; Voltage 500V
C418: 22pF; C_1206_3216Metric; Voltage 500V
C419: 47pF; C_1206_3216Metric; Voltage 500V
C420: 100pF; C_1206_3216Metric; Voltage 500V
C421: 220pF; C_1206_3216Metric; Voltage 500V
C422: 470pF; C_1206_3216Metric; Voltage 500V
C423: 1nF; C_1206_3216Metric; Voltage 500V
K401, K402, K403, K404, K405, K406, K407, K408: HF3F-L-12-1ZL2T; Relay_SPDT_Hongfa_HF3F-L-xx-1ZL2T
Q401, Q402: AO3401A; SOT-23
Q403, Q404: AO3400; SOT-23
R401, R402, R405, R406: 10k; R_0603_1608Metric
R403, R404: 100; R_0603_1608Metric

Connections:
+12V: Q401.3 (S), Q402.3 (S), R401.2, R402.2; also elsewhere on the board
/Capacitors_Bank/Cap1: C417.1, K402.14
/Capacitors_Bank/Cap2: C418.1, K403.14
/Capacitors_Bank/Cap3: C419.1, K404.14
/Capacitors_Bank/Cap4: C420.1, K405.14
/Capacitors_Bank/Cap5: C421.1, K406.14
/Capacitors_Bank/Cap6: C422.1, K407.14
/Capacitors_Bank/Cap7: C423.1, K408.14
/Capacitors_Bank/Cap12v_1: C401.2, C402.1, C403.2, C404.1, C405.2, C406.1, C407.2, C408.1, K401.A3, K402.A3, K403.A3, K404.A3, Q401.1 (D)
/Capacitors_Bank/Cap12v_2: C409.2, C410.1, C411.2, C412.1, C413.2, C414.1, C415.2, C416.1, K405.A3, K406.A3, K407.A3, K408.A3, Q402.1 (D)
/Capacitors_Bank/Caps: K401.11, K402.11, K403.11, K404.11, K405.11, K406.11, K407.11, K408.11
/Capacitors_Bank/R1: C401.1, C409.1, K401.A2, K405.A2; also elsewhere on the board
/Capacitors_Bank/R2: C403.1, C411.1, K402.A2, K406.A2; also elsewhere on the board
/Capacitors_Bank/R3: C405.1, C413.1, K403.A2, K407.A2; also elsewhere on the board
/Capacitors_Bank/R4: C407.1, C415.1, K404.A2, K408.A2; also elsewhere on the board
/Capacitors_Bank/RF_In: K401.14; also elsewhere on the board
/Capacitors_Bank/S1: C402.2, C410.2, K401.A1, K405.A1; also elsewhere on the board
/Capacitors_Bank/S2: C404.2, C412.2, K402.A1, K406.A1; also elsewhere on the board
/Capacitors_Bank/S3: C406.2, C414.2, K403.A1, K407.A1; also elsewhere on the board
/Capacitors_Bank/S4: C408.2, C416.2, K404.A1, K408.A1; also elsewhere on the board
/Controller/CapRels_1: R403.2; also elsewhere on the board
/Controller/CapRels_2: R404.2; also elsewhere on the board
/RF_Out: K401.12; also elsewhere on the board
GND: C417.2, C418.2, C419.2, C420.2, C421.2, C422.2, C423.2; also elsewhere on the board
GNDD: Q403.1 (D), Q404.1 (D), R405.1, R406.1; also elsewhere on the board
unnamed: Q401.2 (G), Q403.3 (S), R401.1
unnamed: Q402.2 (G), Q404.3 (S), R402.1
unnamed: Q403.2 (G), R403.1, R405.2
unnamed: Q404.2 (G), R404.1, R406.2

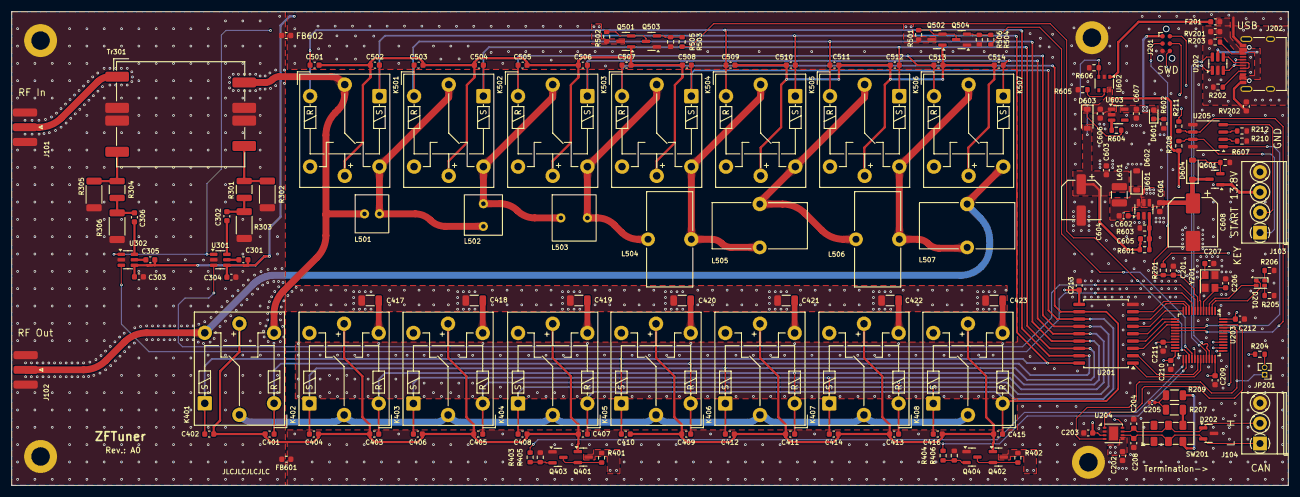
[picture p22: board ZFTuner.kicad_pcb from above]

Board: 4 copper layers, 221.0 x 82.0 mm, 168 parts (0 on the bottom side), 108 nets.
