TiZed/ZFTuner/Firmware/Core/Src/main.c

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
/* Includes ------------------------------------------------------------------*/
#include "main.h"
#include "usb_device.h"

/* USER CODE BEGIN Includes */
#include "usb_redirect.h"
#include "usbd_cdc_if.h"

#include "latching_relays.h"
#include "ltc5507.h"

/* USER CODE END Includes */

ADC_HandleTypeDef hadc1;
DMA_HandleTypeDef hdma_adc1;

CORDIC_HandleTypeDef hcordic;

FDCAN_HandleTypeDef hfdcan1;

FMAC_HandleTypeDef hfmac;

TIM_HandleTypeDef htim1;

/* USER CODE BEGIN PV */
relay_t Cap_InOut = {Relays_R1_GPIO_Port, CapRels_1_GPIO_Port, Relays_S1_Pin, Relays_R1_Pin, CapRels_1_Pin} ;

relay_t Cap_K402 = {Relays_R1_GPIO_Port, CapRels_1_GPIO_Port, Relays_S2_Pin, Relays_R2_Pin, CapRels_1_Pin} ;
relay_t Cap_K403 = {Relays_R1_GPIO_Port, CapRels_1_GPIO_Port, Relays_S3_Pin, Relays_R3_Pin, CapRels_1_Pin} ;
relay_t Cap_K404 = {Relays_R1_GPIO_Port, CapRels_1_GPIO_Port, Relays_S4_Pin, Relays_R4_Pin, CapRels_1_Pin} ;
relay_t Cap_K405 = {Relays_R1_GPIO_Port, CapRels_2_GPIO_Port, Relays_S1_Pin, Relays_R1_Pin, CapRels_2_Pin} ;
relay_t Cap_K406 = {Relays_R1_GPIO_Port, CapRels_2_GPIO_Port, Relays_S2_Pin, Relays_R2_Pin, CapRels_2_Pin} ;
relay_t Cap_K407 = {Relays_R1_GPIO_Port, CapRels_2_GPIO_Port, Relays_S3_Pin, Relays_R3_Pin, CapRels_2_Pin} ;
relay_t Cap_K408 = {Relays_R1_GPIO_Port, CapRels_2_GPIO_Port, Relays_S4_Pin, Relays_R4_Pin, CapRels_2_Pin} ;

relay_t Ind_K501 = {Relays_R1_GPIO_Port, IndRels_1_GPIO_Port, Relays_S1_Pin, Relays_R1_Pin, IndRels_1_Pin} ;
relay_t Ind_K502 = {Relays_R1_GPIO_Port, IndRels_1_GPIO_Port, Relays_S2_Pin, Relays_R2_Pin, IndRels_1_Pin} ;
relay_t Ind_K503 = {Relays_R1_GPIO_Port, IndRels_1_GPIO_Port, Relays_S3_Pin, Relays_R3_Pin, IndRels_1_Pin} ;
relay_t Ind_K504 = {Relays_R1_GPIO_Port, IndRels_1_GPIO_Port, Relays_S4_Pin, Relays_R4_Pin, IndRels_1_Pin} ;
relay_t Ind_K505 = {Relays_R1_GPIO_Port, IndRels_2_GPIO_Port, Relays_S1_Pin, Relays_R1_Pin, IndRels_2_Pin} ;
relay_t Ind_K506 = {Relays_R1_GPIO_Port, IndRels_2_GPIO_Port, Relays_S2_Pin, Relays_R2_Pin, IndRels_2_Pin} ;
relay_t Ind_K507 = {Relays_R1_GPIO_Port, IndRels_2_GPIO_Port, Relays_S3_Pin, Relays_R3_Pin, IndRels_2_Pin} ;

volatile uint16_t adc_data[4] ;

uint16_t rf_fwd_mv ;
uint16_t rf_rfl_mv ; 
uint16_t ref_volt ;
uint16_t int_temp ;
/* USER CODE END PV */

void SystemClock_Config(void);
static void MX_GPIO_Init(void);
static void MX_DMA_Init(void);
static void MX_ADC1_Init(void);
static void MX_CORDIC_Init(void);
static void MX_FDCAN1_Init(void);
static void MX_FMAC_Init(void);
static void MX_TIM1_Init(void);
/* USER CODE BEGIN 0 */
uint8_t getActiveBank() {
    volatile uint32_t remap = READ_BIT(SYSCFG->MEMRMP, 0x1 << 8);
    return remap == 0 ? 1 : 2;
}

/* USER CODE END 0 */

/**
  * @brief  The application entry point.
  * @retval int
  */
int main(void)
{

  /* USER CODE BEGIN 1 */
  FDCAN_TxHeaderTypeDef can_header ;
  FDCAN_FilterTypeDef can_filter ;

  /* USER CODE END 1 */

  /* MCU Configuration--------------------------------------------------------*/

  /* Reset of all peripherals, Initializes the Flash interface and the Systick. */
  HAL_Init();

  /* Configure the system clock */
  SystemClock_Config();

  /* Initialize all configured peripherals */
  MX_GPIO_Init();
  MX_DMA_Init();
  MX_ADC1_Init();
  MX_CORDIC_Init();
  MX_FDCAN1_Init();
  MX_FMAC_Init();
  MX_USB_Device_Init();
  MX_TIM1_Init();
  /* USER CODE BEGIN 2 */

  HAL_ADCEx_Calibration_Start(&hadc1, ADC_SINGLE_ENDED) ;
  HAL_GPIO_WritePin(Op_LED_GPIO_Port, Op_LED_Pin, GPIO_PIN_RESET) ;
  HAL_GPIO_WritePin(Error_LED_GPIO_Port, Error_LED_Pin, GPIO_PIN_SET) ;

  // Turn off all relays signal
  GPIO_TypeDef * Relays_Port = Relays_R1_GPIO_Port ;
  uint16_t All_Relays = Relays_S1_Pin | Relays_R1_Pin | Relays_S2_Pin | Relays_S3_Pin | Relays_R3_Pin | Relays_S4_Pin | Relays_R4_Pin ; 

  GPIO_TypeDef * Relays_Power_Port = IndRels_1_GPIO_Port ;
  uint16_t All_Power = IndRels_1_Pin | IndRels_2_Pin | CapRels_1_Pin | CapRels_2_Pin ;

  Relays_Port->BRR = All_Relays ;
  Relays_Power_Port->BRR = All_Power ;

  // Shutdown all devices 
  HAL_GPIO_WritePin(SWR_SHDN_GPIO_Port, SWR_SHDN_Pin, GPIO_PIN_SET) ; // Shutdown SWR meter
  HAL_GPIO_WritePin(CAN_STBY_GPIO_Port, CAN_STBY_Pin, GPIO_PIN_RESET) ; // Shutdown CAN transceiver 

  HAL_GPIO_WritePin(KEY_GPIO_Port, KEY_Pin, GPIO_PIN_RESET) ; // Disable KEY signal

  can_filter.IdType = FDCAN_STANDARD_ID ; 
  can_filter.FilterIndex = 0 ;
  can_filter.FilterType = FDCAN_FILTER_MASK ;
  can_filter.FilterConfig = FDCAN_FILTER_TO_RXFIFO0 ;
  can_filter.FilterID1 = 0x11 ;
  can_filter.FilterID1 = 0x11 ;

  if(HAL_FDCAN_ConfigFilter(&hfdcan1, &can_filter) != HAL_OK) Error_Handler() ; 
  

  uint32_t Caps[] = {12, 22, 47, 100, 220, 470, 100}  ; // pF
  uint32_t Inds[] = {505, 1000, 2200, 5000, 10000, 23000, 44700} ; // 0.1 nH

  /* USER CODE END 2 */

  /* Infinite loop */
  /* USER CODE BEGIN WHILE */
  HAL_Delay(500) ;
  printf("Turn off 'Err' LED\n") ;
  HAL_GPIO_WritePin(Error_LED_GPIO_Port, Error_LED_Pin, GPIO_PIN_RESET) ;
  uint8_t fw_bank = getActiveBank() ;
  printf("Current FW bank: %d", fw_bank) ;

  HAL_GPIO_WritePin(SWR_SHDN_GPIO_Port, SWR_SHDN_Pin, GPIO_PIN_RESET) ; // Enable SWR meter
  HAL_GPIO_WritePin(CAN_STBY_GPIO_Port, CAN_STBY_Pin, GPIO_PIN_SET) ; // Enable CAN transceiver

  // Start ADC cyclic conversion
  HAL_TIM_Base_Init(&htim1) ;
  HAL_ADC_Start_DMA(&hadc1, (uint32_t *) adc_data, 4) ;

  while (1)
  {
    /* USER CODE END WHILE */

    /* USER CODE BEGIN 3 */
  }
  /* USER CODE END 3 */
}

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
