TiZed/ZFTuner/Firmware/Firmware.ioc

Mcu.UserName=STM32G431CBTx
PA0.GPIO_Label=Rfl_V
PA0.Signal=ADC1_IN1
PA1.GPIO_Label=Fwd_V
PA1.Signal=ADC1_IN2
PA11.Signal=USB_DM
PA12.Signal=USB_DP
PA13.Signal=SYS_JTMS-SWDIO
PA14.Signal=SYS_JTCK-SWCLK
PA2.GPIO_Label=Relays_R4
PA2.Signal=GPIO_Output
PA3.GPIO_Label=Relays_S4
PA3.Signal=GPIO_Output
PA4.GPIO_Label=Relays_R3
PA4.Signal=GPIO_Output
PA5.GPIO_Label=Relays_S3
PA5.Signal=GPIO_Output
PA6.GPIO_Label=Relays_R2
PA6.Signal=GPIO_Output
PA7.GPIO_Label=Relays_S2
PA7.Signal=GPIO_Output
PA8.GPIO_Label=Relays_R1
PA8.Signal=GPIO_Output
PA9.GPIO_Label=Relays_S1
PA9.Signal=GPIO_Output
PB0.GPIO_Label=KEY
PB0.Signal=GPIO_Output
PB1.GPIO_Label=START
PB1.Signal=GPXTI1
PB11.GPIO_Label=CapRels_1
PB11.Signal=GPIO_Output
PB12.GPIO_Label=CapRels_2
PB12.Signal=GPIO_Output
PB13.GPIO_Label=IndRels_1
PB13.Signal=GPIO_Output
PB14.GPIO_Label=IndRels_2
PB14.Signal=GPIO_Output
PB15.GPIO_Label=SWR_SHDN
PB15.Signal=GPIO_Output
PB3.Signal=SYS_JTDO-SWO
PB7.GPIO_Label=CAN_STBY
PB7.Signal=GPIO_Output
PB8-BOOT0.Signal=FDCAN1_RX
PB9.Signal=FDCAN1_TX
PC13.GPIO_Label=Op_LED
PC13.Signal=GPIO_Output
PC14-OSC32_IN.GPIO_Label=Error_LED
PC14-OSC32_IN.Signal=GPIO_Output
PF0-OSC_IN.Signal=RCC_OSC_IN
PF1-OSC_OUT.Signal=RCC_OSC_OUT
