TiZed/ZFTuner/(commit log)

2024-03-23 First commit, schematic mostly done
    [BN43-202.step, Directional_Coupler.FCStd, Directional_Coupler.kicad_pcb, Directional_Coupler.kicad_sch, Directional_Coupler.step, Power.kicad_sch, ZFTuner.kicad_pcb, ZFTuner.kicad_sch]
2024-04-04 Add some missing footprints and rearranged schematics a bit
    [ZFTuner.kicad_sch, controller.kicad_sch]
2024-04-04 Added comments for inductors structure
    [inductors_bank.kicad_sch]
2024-04-04 3D printable coil forms with parametric CAD file
    [Coil_Form-4.3D_3.25CL_5.24L_6.3H_50.5nH_N3.stl, Coil_Form-4.3D_4.55CL_6.55L_6.3H_100.3nH_N5.stl, Coil_Form-5.7D_5.2CL_7.2L_7.7H_222nH_N6.stl, Coil_Form.FCStd]
2024-04-14 Fixed 3D printed air inductors dimensions
    [Coil_Form-4.3D_3.25CL_5.24L_6.3H_50.5nH_N3.stl, Coil_Form-4.3D_3.35CL_5.35L_6.3H_50.5nH_N3.stl, Coil_Form-4.3D_4.55CL_6.55L_6.3H_100.3nH_N5.stl, Coil_Form-4.3D_4.69CL_6.69L_6.3H_100.3nH_N5.stl, Coil_Form-5.7D_5.2CL_7.2L_7.7H_222nH_N6.stl, Coil_Form-5.7D_5.36CL_7.36L_7.7H_222nH_N6.stl, Coil_Form.FCStd]
2024-04-14 Inductors footprints
2024-04-14 Set footprints for inductors. Improved schematic of capcitors and inductors banks.
    [capacitors_bank.kicad_sch, inductors_bank.kicad_sch]
2024-04-14 Added connectors to top schematic. Added xtal and optocouplers to controller.
    [ZFTuner.kicad_sch, controller.kicad_sch]
2024-04-14 Updated all pins in STM32CubeMX project
2024-04-14 Added 'Power', 'Op' and 'Error' LEDs
    [Power.kicad_sch, controller.kicad_sch]
2024-04-14 Added ADC configuration to FW
2024-04-14 Created PDF of schematic
    [Power.kicad_sch, ZFTuner.kicad_sch, capacitors_bank.kicad_sch, controller.kicad_sch, inductors_bank.kicad_sch, swr_meter.kicad_sch]
2024-04-14 Added LEDs part numbers
    [Power.kicad_sch, controller.kicad_sch]
2024-04-15 Start layout
    [Coil_Form.FCStd, ZFTuner.kicad_pcb]
2024-04-17 Placement of most components done
    [ZFTuner.kicad_pcb]
2024-04-20 Added missing silkscreen frame for 3DP inductors
2024-04-20 PCB layout nearly done
    [ZFTuner.kicad_pcb]
2024-04-20 Schematic fixes for PCB layout
    [Power.kicad_sch, ZFTuner.kicad_sch, capacitors_bank.kicad_sch, controller.kicad_sch, inductors_bank.kicad_sch]
2024-04-21 Everything is connected
    [ZFTuner.kicad_pcb]
2024-04-23 Adjusted some traces
    [ZFTuner.kicad_pcb]
2024-04-23 Updated schematic PDF
    [Power.kicad_sch, ZFTuner.kicad_sch, capacitors_bank.kicad_sch, controller.kicad_sch, inductors_bank.kicad_sch, swr_meter.kicad_sch]
2024-04-24 Some pictures of the board
2024-04-24 Many more vias, improved some routing
    [Power.kicad_sch, ZFTuner.kicad_pcb, ZFTuner.kicad_sch, capacitors_bank.kicad_sch, controller.kicad_sch, inductors_bank.kicad_sch]
2024-04-25 Some schematic cleanup and minor fixes
    [Power.kicad_sch, ZFTuner.kicad_sch, capacitors_bank.kicad_sch, controller.kicad_sch, inductors_bank.kicad_sch, swr_meter.kicad_sch]
2024-04-25 More layout polishing
    [ZFTuner.kicad_pcb]
2024-04-26 Removed unclear text in schematic. Some minor PCB routing improvments. Added name and revision silkscreen
    [Power.kicad_sch, ZFTuner.kicad_pcb]
2024-04-27 Replaced SMA footprints with correct connectors
    [ZFTuner-B_Cu.gbl, ZFTuner-B_Mask.gbs, ZFTuner-B_Paste.gbp, ZFTuner-B_Silkscreen.gbo, ZFTuner-Edge_Cuts.gm1, ZFTuner-F_Cu.gtl, ZFTuner-F_Mask.gts, ZFTuner-F_Paste.gtp]
2024-04-28 Improved grounding
    [Power.kicad_sch, ZFTuner.kicad_pcb, controller.kicad_sch]
2024-04-29 Improve RF routing
    [Power.kicad_sch, ZFTuner.kicad_pcb, ZFTuner.kicad_sch, capacitors_bank.kicad_sch, controller.kicad_sch, inductors_bank.kicad_sch, swr_meter.kicad_sch]
2024-04-29 Readded some vias and fixed board dimensions
    [ZFTuner.kicad_pcb]
2024-04-29 Added transistors parts. Added reverse polarity protection, pending adding to layout
    [Power.kicad_sch, ZFTuner.kicad_sch, capacitors_bank.kicad_sch, inductors_bank.kicad_sch]
2024-05-02 Finshed and added revers polarity protection. Improved layout.
    [Power.kicad_sch, ZFTuner.kicad_pcb]
2024-05-02 Fixed 5.4V zone geometry
    [ZFTuner.kicad_pcb]
2024-05-03 Re-stiched GNDD vias. Added mounting holes.
    [ZFTuner.kicad_pcb, ZFTuner.kicad_sch]
2024-05-03 Minor schematic fixes
    [Power.kicad_sch]
2024-05-03 Minor layout improvements
    [ZFTuner.kicad_pcb]
2024-05-04 Finished layout
    [Power.kicad_sch, ZFTuner.kicad_pcb, ZFTuner.kicad_sch, capacitors_bank.kicad_sch, controller.kicad_sch, inductors_bank.kicad_sch, swr_meter.kicad_sch]
2024-05-04 Fixed directional couler footprint. Improved RF In/Out SMA placement.
    [ZFTuner.kicad_pcb]
2024-05-04 Generated prodcution files
    [ZFTuner-B_Cu.gbl, ZFTuner-B_Mask.gbs, ZFTuner-B_Paste.gbp, ZFTuner-B_Silkscreen.gbo, ZFTuner-Edge_Cuts.gm1, ZFTuner-F_Cu.gtl, ZFTuner-F_Mask.gts, ZFTuner-F_Paste.gtp]
2024-05-04 Generated production files for directional coupler PCB
    [Directional_Coupler-B_Cu.gbl, Directional_Coupler-B_Mask.gbs, Directional_Coupler-B_Paste.gbp, Directional_Coupler-B_Silkscreen.gbo, Directional_Coupler-Edge_Cuts.gm1, Directional_Coupler-F_Cu.gtl, Directional_Coupler-F_Mask.gts, Directional_Coupler-F_Paste.gtp]
2024-05-05 Minor slikscreen fixes and direction coupler prodcution files
    [Directional_Coupler-B_Cu.gbl, Directional_Coupler-B_Mask.gbs, Directional_Coupler-B_Paste.gbp, Directional_Coupler-B_Silkscreen.gbo, Directional_Coupler-Edge_Cuts.gm1, Directional_Coupler-F_Cu.gtl, Directional_Coupler-F_Mask.gts, Directional_Coupler-F_Paste.gtp]
2024-05-13 Added relays control code and LTC5507 formula
    [LTC55507_Characteristics.ods]
2024-06-07 Minor vias fixes
    [ZFTuner-B_Cu.gbl, ZFTuner-B_Mask.gbs, ZFTuner-B_Paste.gbp, ZFTuner-B_Silkscreen.gbo, ZFTuner-Edge_Cuts.gm1, ZFTuner-F_Cu.gtl, ZFTuner-F_Mask.gts, ZFTuner-F_Paste.gtp]
2024-07-06 Adapted direction coupler board for JLPCB 2-layer process
    [Directional_Coupler-B_Cu.gbl, Directional_Coupler-B_Mask.gbs, Directional_Coupler-B_Paste.gbp, Directional_Coupler-B_Silkscreen.gbo, Directional_Coupler-Edge_Cuts.gm1, Directional_Coupler-F_Cu.gtl, Directional_Coupler-F_Mask.gts, Directional_Coupler-F_Paste.gtp]
2025-08-20 A0 Production. Updated to KiCad 9.0.x
    [Power.kicad_sch, ZFTuner.kicad_pcb, ZFTuner.kicad_sch, capacitors_bank.kicad_sch, controller.kicad_sch, inductors_bank.kicad_sch, swr_meter.kicad_sch]
